azonenberg/ethernet-tap/board/ethernet-tap.kicad_pcb

## KiCad design board/ethernet-tap.kicad_pcb (2022-12-27)

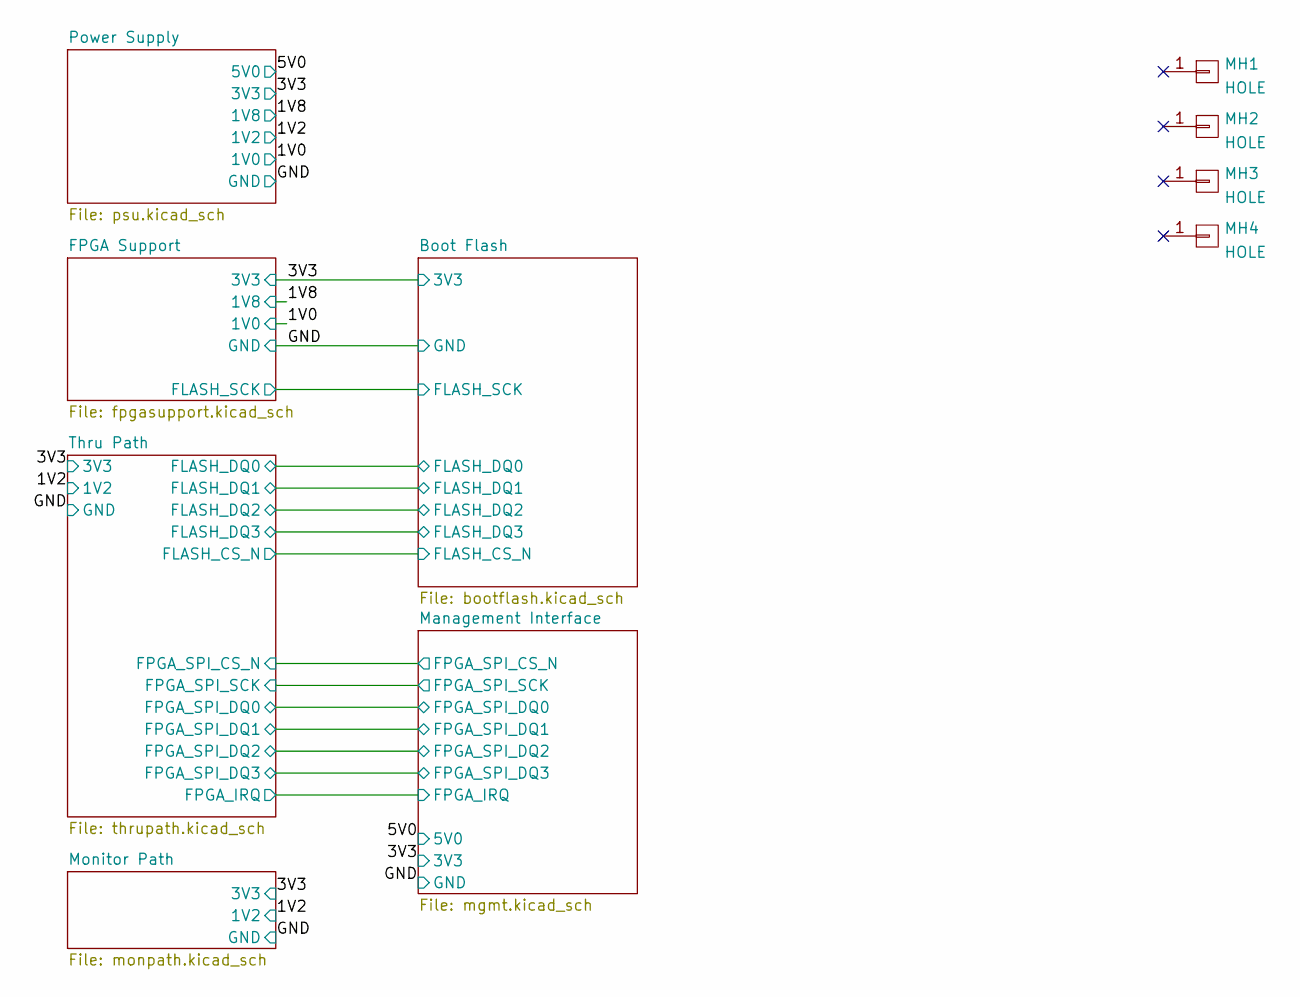
[picture p1: schematic ethernet-tap.kicad_sch, Active 10/100/1000baseT Tap]

Parts:
MH1, MH2, MH3, MH4: HOLE; MECHANICAL_CLEARANCEHOLE_4_40

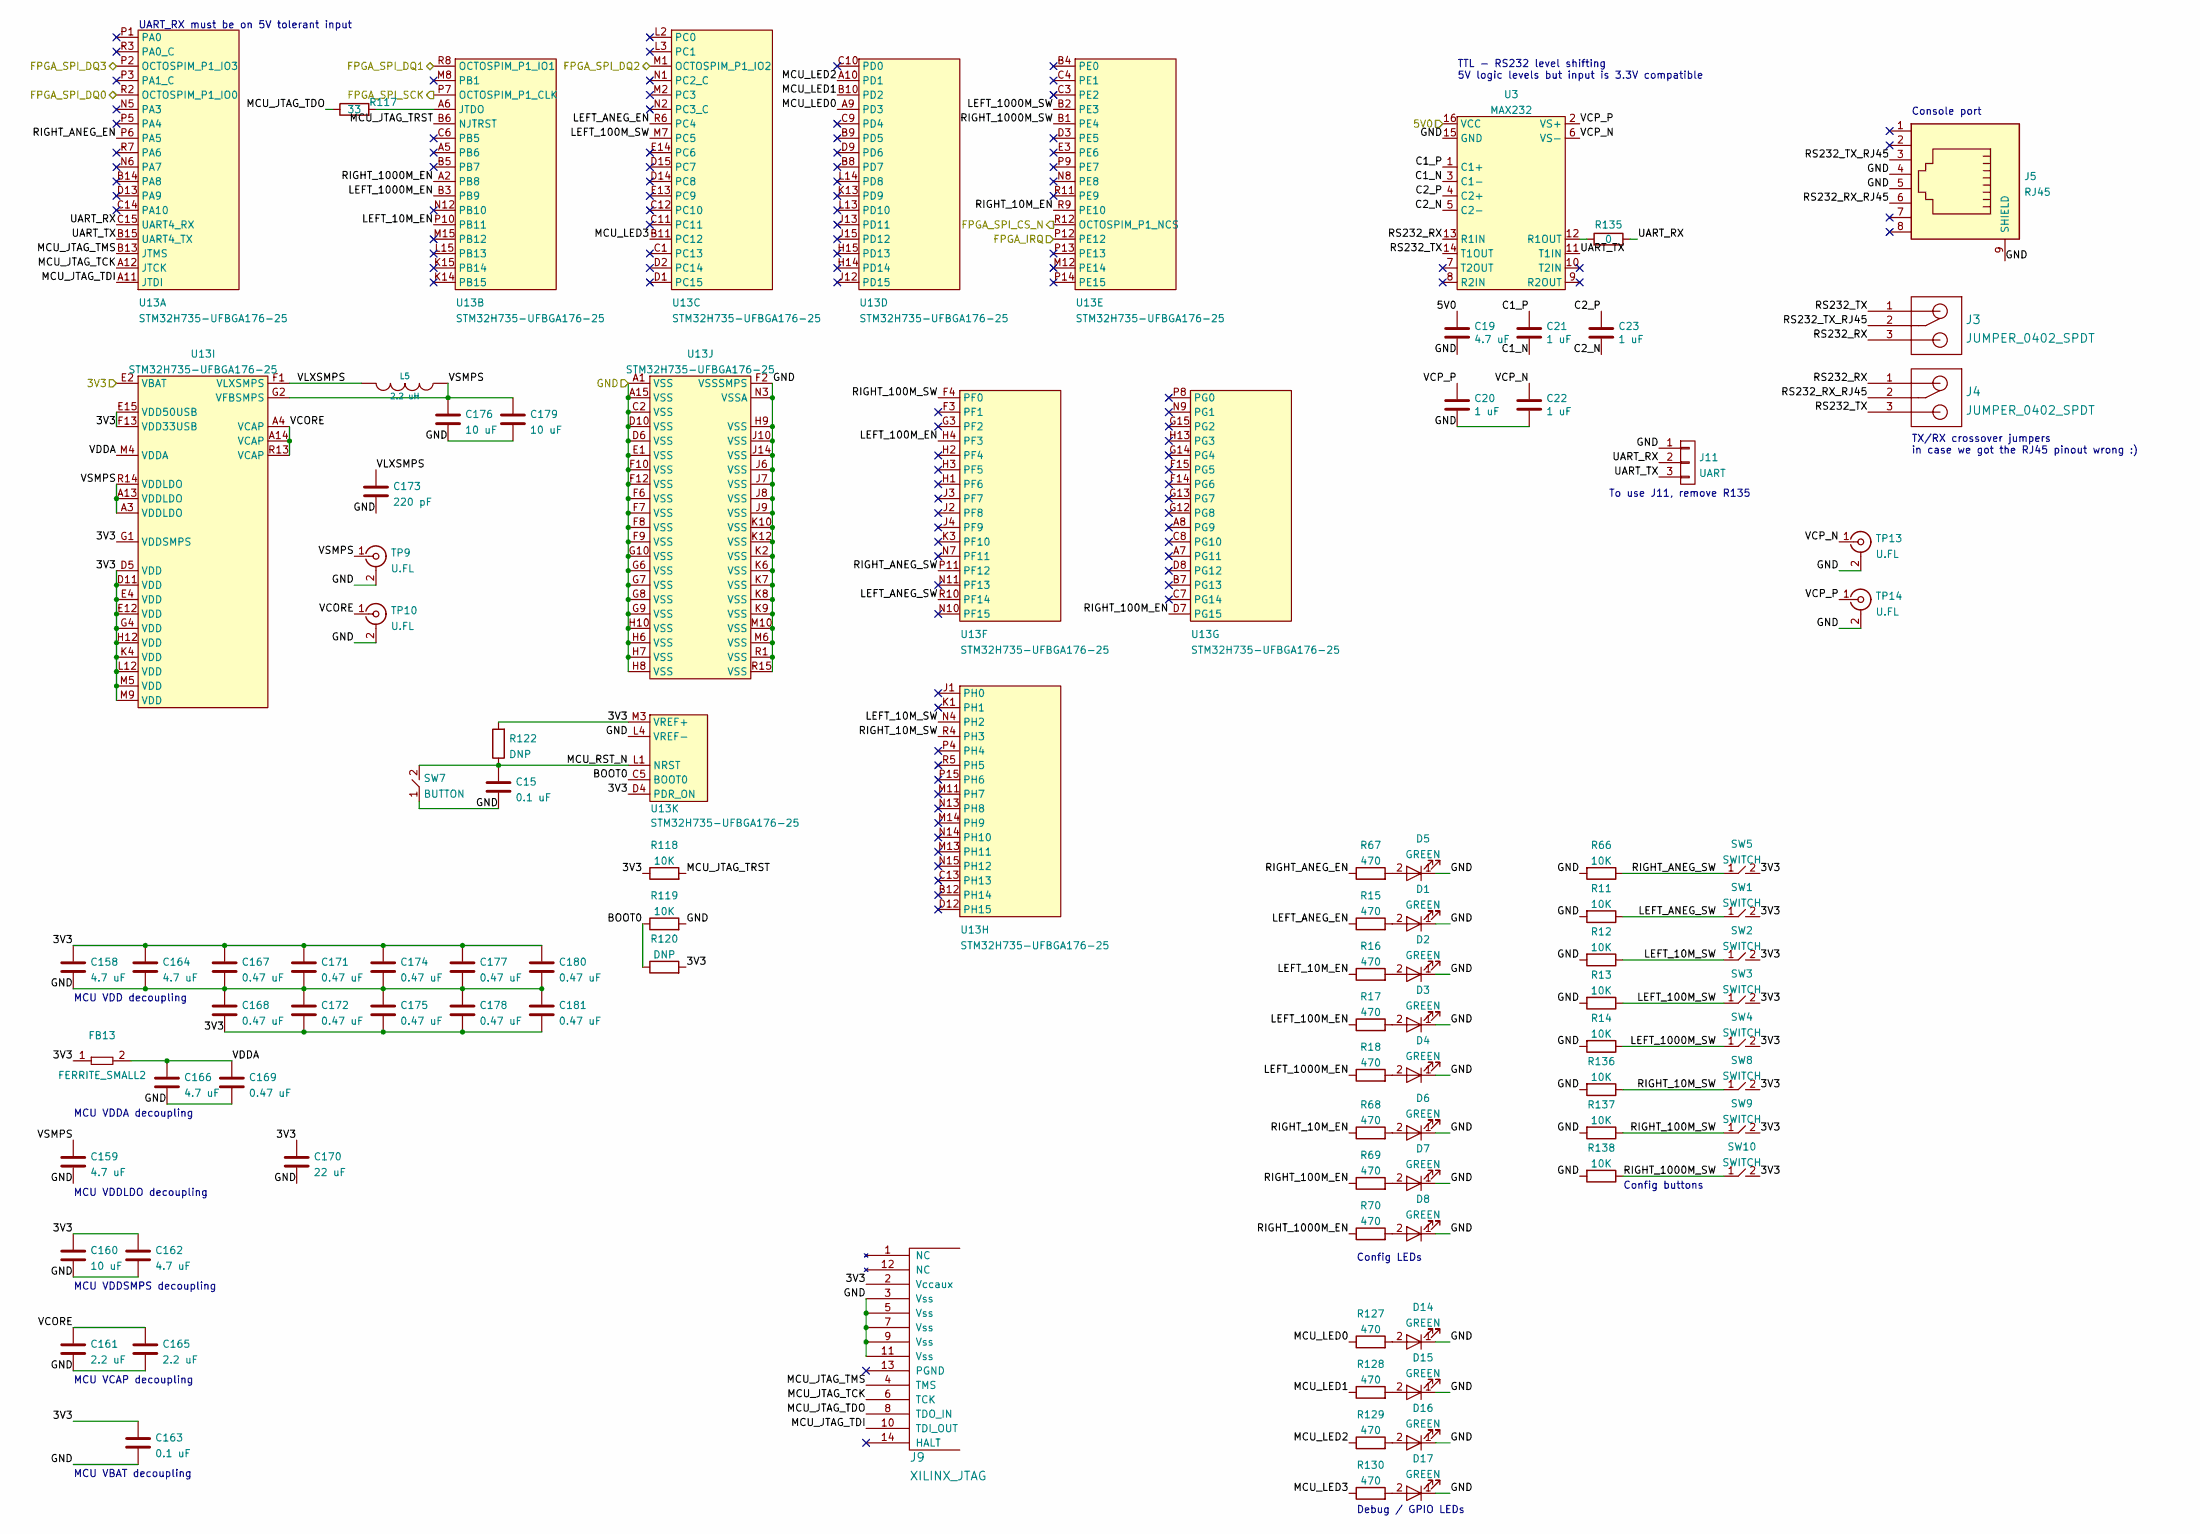
[picture p2: schematic mgmt.kicad_sch, Active 10/100/1000baseT Tap]

Parts:
C15, C163: 0.1 uF; EIA_0402_CAP_NOSILK
C19, C158, C159, C162, C164, C166: 4.7 uF; EIA_0603_CAP_NOSILK
C20, C21, C22, C23: 1 uF; EIA_0603_CAP_NOSILK
C160, C176, C179: 10 uF; EIA_0805_CAP_NOSILK
C161, C165: 2.2 uF; EIA_0603_CAP_NOSILK
C167, C168, C169, C171, C172, C174, C175, C177, C178, C180, C181: 0.47 uF; EIA_0402_CAP_NOSILK
C170: 22 uF; EIA_1206_CAP_NOSILK
C173: 220 pF; EIA_0402_CAP_NOSILK
D1, D2, D3, D4, D5, D6, D7, D8, D14, D15, D16, D17: GREEN; EIA_0603_LED
FB13: FERRITE_SMALL2; EIA_0603_INDUCTOR_NOSILK
J3, J4: JUMPER_0402_SPDT; EIA_0402_JUMPER
J5: RJ45; CONN_RJ45_BELSTEWART_SS-7188S-A-PG4-1-BA-xx
J9: XILINX_JTAG; XILINX_JTAG_PTH_MOLEX_0878311420
J11: UART; CONN_HEADER_2.54MM_1x3
L5: 2.2 uH; EIA_1210_CAP_NOSILK
R11, R12, R13, R14, R66, R118, R119, R136, R137, R138: 10K; EIA_0402_RES_NOSILK
R15, R16, R17, R18, R67, R68, R69, R70, R127, R128, R129, R130: 470; EIA_0402_RES_NOSILK
R117: 33; EIA_0402_RES_NOSILK
R120, R122: DNP; EIA_0402_RES_NOSILK
R135: 0; EIA_0402_RES_NOSILK
SW1, SW2, SW3, SW4, SW5, SW8, SW9, SW10: SWITCH; SWITCH_RAFI_MICON_5
SW7: BUTTON; SWITCH_RAFI_MICON_5
TP9, TP10, TP13, TP14: U.FL; CONN_U.FL_TE_1909763-1
U3: MAX232; SOIC_16_3.9MM
U13: STM32H735-UFBGA176-25; BGA_201_10x10_DEPOP_0.65MM_OSHPARK

Connections:
/3V3: C158.1, C160.1, C162.1, C163.1, C164.1, C167.1, C168.2, C170.1, C171.1, C172.2, C174.1, C175.2, C177.1, C178.2, C180.1, C181.2, FB13.1, J9.2 (Vccaux), R118.1, R120.2, R122.2, SW1.2, SW2.2, SW3.2, SW4.2, SW5.2, SW8.2, SW9.2, SW10.2, U13.D4 (PDR_ON), U13.D5 (VDD), U13.D11 (VDD), U13.E2 (VBAT), U13.E4 (VDD), U13.E12 (VDD), U13.E15 (VDD50USB), U13.F13 (VDD33USB), U13.G1 (VDDSMPS), U13.G4 (VDD), U13.H12 (VDD), U13.K4 (VDD), U13.L12 (VDD), U13.M3 (VREF+), U13.M5 (VDD), U13.M9 (VDD); also elsewhere on the board
/5V0: C19.1, U3.16 (VCC); also elsewhere on the board
/GND: C15.2, C19.2, C20.2, C22.2, C158.2, C159.2, C160.2, C161.2, C162.2, C163.2, C164.2, C165.2, C166.2, C167.2, C168.1, C169.2, C170.2, C171.2, C172.1, C173.2, C174.2, C175.1, C176.2, C177.2, C178.1, C179.2, C180.2, C181.1, D1.1 (K), D2.1 (K), D3.1 (K), D4.1 (K), D5.1 (K), D6.1 (K), D7.1 (K), D8.1 (K), D14.1 (K), D15.1 (K), D16.1 (K), D17.1 (K), J5.4, J5.5, J5.9 (SHIELD), J9.3 (Vss), J9.5 (Vss), J9.7 (Vss), J9.9 (Vss), J9.11 (Vss), J11.1, R11.2, R12.2, R13.2, R14.2, R66.2, R119.2, R136.2, R137.2, R138.2, SW7.1, TP9.2 (Ext), TP10.2 (Ext), TP13.2 (Ext), TP14.2 (Ext), U3.15 (GND), U13.A1 (VSS), U13.A15 (VSS), U13.C2 (VSS), U13.D6 (VSS), U13.D10 (VSS), U13.E1 (VSS), U13.F2 (VSSSMPS), U13.F6 (VSS), U13.F7 (VSS), U13.F8 (VSS), U13.F9 (VSS), U13.F10 (VSS), U13.F12 (VSS), U13.G6 (VSS), U13.G7 (VSS), U13.G8 (VSS), U13.G9 (VSS), U13.G10 (VSS), U13.H6 (VSS), U13.H7 (VSS), U13.H8 (VSS), U13.H9 (VSS), U13.H10 (VSS), U13.J6 (VSS), U13.J7 (VSS), U13.J8 (VSS), U13.J9 (VSS), U13.J10 (VSS), U13.J14 (VSS), U13.K2 (VSS), U13.K6 (VSS), U13.K7 (VSS), U13.K8 (VSS), U13.K9 (VSS), U13.K10 (VSS), U13.K12 (VSS), U13.L4 (VREF-), U13.M6 (VSS), U13.M10 (VSS), U13.N3 (VSSA), U13.R1 (VSS), U13.R15 (VSS); also elsewhere on the board
/Management Interface/BOOT0: R119.1, R120.1, U13.C5 (BOOT0)
/Management Interface/C1_N: C21.2, U3.3 (C1-)
/Management Interface/C1_P: C21.1, U3.1 (C1+)
/Management Interface/C2_N: C23.2, U3.5 (C2-)
/Management Interface/C2_P: C23.1, U3.4 (C2+)
/Management Interface/FPGA_IRQ: U13.P12 (PE12); also elsewhere on the board
/Management Interface/FPGA_SPI_CS_N: U13.R12 (OCTOSPIM_P1_NCS); also elsewhere on the board
/Management Interface/FPGA_SPI_DQ0: U13.R2 (OCTOSPIM_P1_IO0); also elsewhere on the board
/Management Interface/FPGA_SPI_DQ1: U13.R8 (OCTOSPIM_P1_IO1); also elsewhere on the board
/Management Interface/FPGA_SPI_DQ2: U13.M1 (OCTOSPIM_P1_IO2); also elsewhere on the board
/Management Interface/FPGA_SPI_DQ3: U13.P2 (OCTOSPIM_P1_IO3); also elsewhere on the board
/Management Interface/FPGA_SPI_SCK: U13.P7 (OCTOSPIM_P1_CLK); also elsewhere on the board
/Management Interface/LEFT_10M_EN: R16.1, U13.P10 (PB11)
/Management Interface/LEFT_10M_SW: R12.1, SW2.1, U13.N4 (PH2)
/Management Interface/LEFT_100M_EN: R17.1, U13.H4 (PF3)
/Management Interface/LEFT_100M_SW: R13.1, SW3.1, U13.M7 (PC5)
/Management Interface/LEFT_1000M_EN: R18.1, U13.B3 (PB9)
/Management Interface/LEFT_1000M_SW: R14.1, SW4.1, U13.B2 (PE3)
/Management Interface/LEFT_ANEG_EN: R15.1, U13.R6 (PC4)
/Management Interface/LEFT_ANEG_SW: R11.1, SW1.1, U13.R10 (PF14)
/Management Interface/MCU_JTAG_TCK: J9.6 (TCK), U13.A12 (JTCK)
/Management Interface/MCU_JTAG_TDI: J9.10 (TDI_OUT), U13.A11 (JTDI)
/Management Interface/MCU_JTAG_TDO: J9.8 (TDO_IN), R117.1
/Management Interface/MCU_JTAG_TMS: J9.4 (TMS), U13.B13 (JTMS)
/Management Interface/MCU_JTAG_TRST: R118.2, U13.B6 (NJTRST)
/Management Interface/MCU_LED0: R127.1, U13.A9 (PD3)
/Management Interface/MCU_LED1: R128.1, U13.B10 (PD2)
/Management Interface/MCU_LED2: R129.1, U13.A10 (PD1)
/Management Interface/MCU_LED3: R130.1, U13.B11 (PC12)
/Management Interface/MCU_RST_N: C15.1, R122.1, SW7.2, U13.L1 (NRST)
/Management Interface/RIGHT_10M_EN: R68.1, U13.R9 (PE10)
/Management Interface/RIGHT_10M_SW: R136.1, SW8.1, U13.R4 (PH3)
/Management Interface/RIGHT_100M_EN: R69.1, U13.D7 (PG15)
/Management Interface/RIGHT_100M_SW: R137.1, SW9.1, U13.F4 (PF0)
/Management Interface/RIGHT_1000M_EN: R70.1, U13.A2 (PB8)
/Management Interface/RIGHT_1000M_SW: R138.1, SW10.1, U13.B1 (PE4)
/Management Interface/RIGHT_ANEG_EN: R67.1, U13.P6 (PA5)
/Management Interface/RIGHT_ANEG_SW: R66.1, SW5.1, U13.P11 (PF12)
/Management Interface/RS232_RX: J3.3, J4.1, U3.13 (R1IN)
/Management Interface/RS232_RX_RJ45: J4.2, J5.6
/Management Interface/RS232_TX: J3.1, J4.3, U3.14 (T1OUT)
/Management Interface/RS232_TX_RJ45: J3.2, J5.3
/Management Interface/UART_RX: J11.2, R135.2, U13.C15 (UART4_RX)
/Management Interface/UART_TX: J11.3, U3.11 (T1IN), U13.B15 (UART4_TX)
/Management Interface/VCORE: C161.1, C165.1, TP10.1 (In), U13.A4 (VCAP), U13.A14 (VCAP), U13.R13 (VCAP)
/Management Interface/VCP_N: C22.1, TP13.1 (In), U3.6 (VS-)
/Management Interface/VCP_P: C20.1, TP14.1 (In), U3.2 (VS+)
/Management Interface/VDDA: C166.1, C169.1, FB13.2, U13.M4 (VDDA)
/Management Interface/VLXSMPS: C173.1, L5.2, U13.F1 (VLXSMPS)
/Management Interface/VSMPS: C159.1, C176.1, C179.1, L5.1, TP9.1 (In), U13.A3 (VDDLDO), U13.A13 (VDDLDO), U13.G2 (VFBSMPS), U13.R14 (VDDLDO)
unnamed: D1.2 (A), R15.2
unnamed: D2.2 (A), R16.2
unnamed: D3.2 (A), R17.2
unnamed: D4.2 (A), R18.2
unnamed: D5.2 (A), R67.2
unnamed: D6.2 (A), R68.2
unnamed: D7.2 (A), R69.2
unnamed: D8.2 (A), R70.2
unnamed: D14.2 (A), R127.2
unnamed: D15.2 (A), R128.2
unnamed: D16.2 (A), R129.2
unnamed: D17.2 (A), R130.2
unnamed: R117.2, U13.A6 (JTDO)
unnamed: R135.1, U3.12 (R1OUT)

Notes on the sheet:
TX/RX crossover jumpers in case we got the RJ45 pinout wrong :)
MCU VCAP decoupling
Config buttons
Console port
UART_RX must be on 5V tolerant input
To use J11, remove R135
MCU VDDSMPS decoupling
MCU VDDA decoupling
MCU VBAT decoupling
MCU VDD decoupling
Debug / GPIO LEDs
Config LEDs
MCU VDDLDO decoupling
TTL - RS232 level shifting 5V logic levels but input is 3.3V compatible

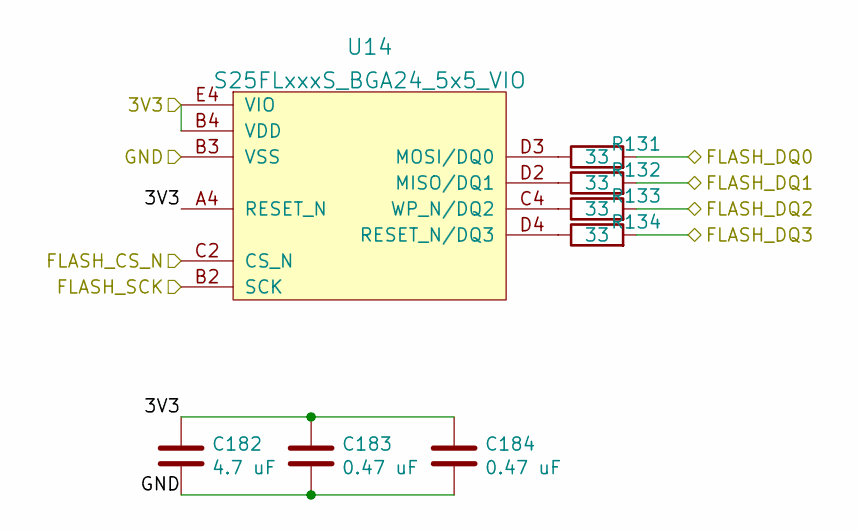
[picture p3: schematic bootflash.kicad_sch, Active 10/100/1000baseT Tap]

Parts:
C182: 4.7 uF; EIA_0603_CAP_NOSILK
C183, C184: 0.47 uF; EIA_0402_CAP_NOSILK
R131, R132, R133, R134: 33; EIA_0402_RES_NOSILK
U14: S25FLxxxS_BGA24_5x5_VIO; BGA_24_6x8_DEPOP1_1MM

Connections:
/3V3: C182.1, C183.1, C184.1, U14.A4 (RESET_N), U14.B4 (VDD), U14.E4 (VIO); also elsewhere on the board
/Boot Flash/FLASH_CS_N: U14.C2 (CS_N); also elsewhere on the board
/Boot Flash/FLASH_DQ0: R131.2; also elsewhere on the board
/Boot Flash/FLASH_DQ1: R132.2; also elsewhere on the board
/Boot Flash/FLASH_DQ2: R133.2; also elsewhere on the board
/Boot Flash/FLASH_DQ3: R134.2; also elsewhere on the board
/Boot Flash/FLASH_SCK: U14.B2 (SCK); also elsewhere on the board
/GND: C182.2, C183.2, C184.2, U14.B3 (VSS); also elsewhere on the board
unnamed: R131.1, U14.D3 (MOSI/DQ0)
unnamed: R132.1, U14.D2 (MISO/DQ1)
unnamed: R133.1, U14.C4 (WP_N/DQ2)
unnamed: R134.1, U14.D4 (RESET_N/DQ3)

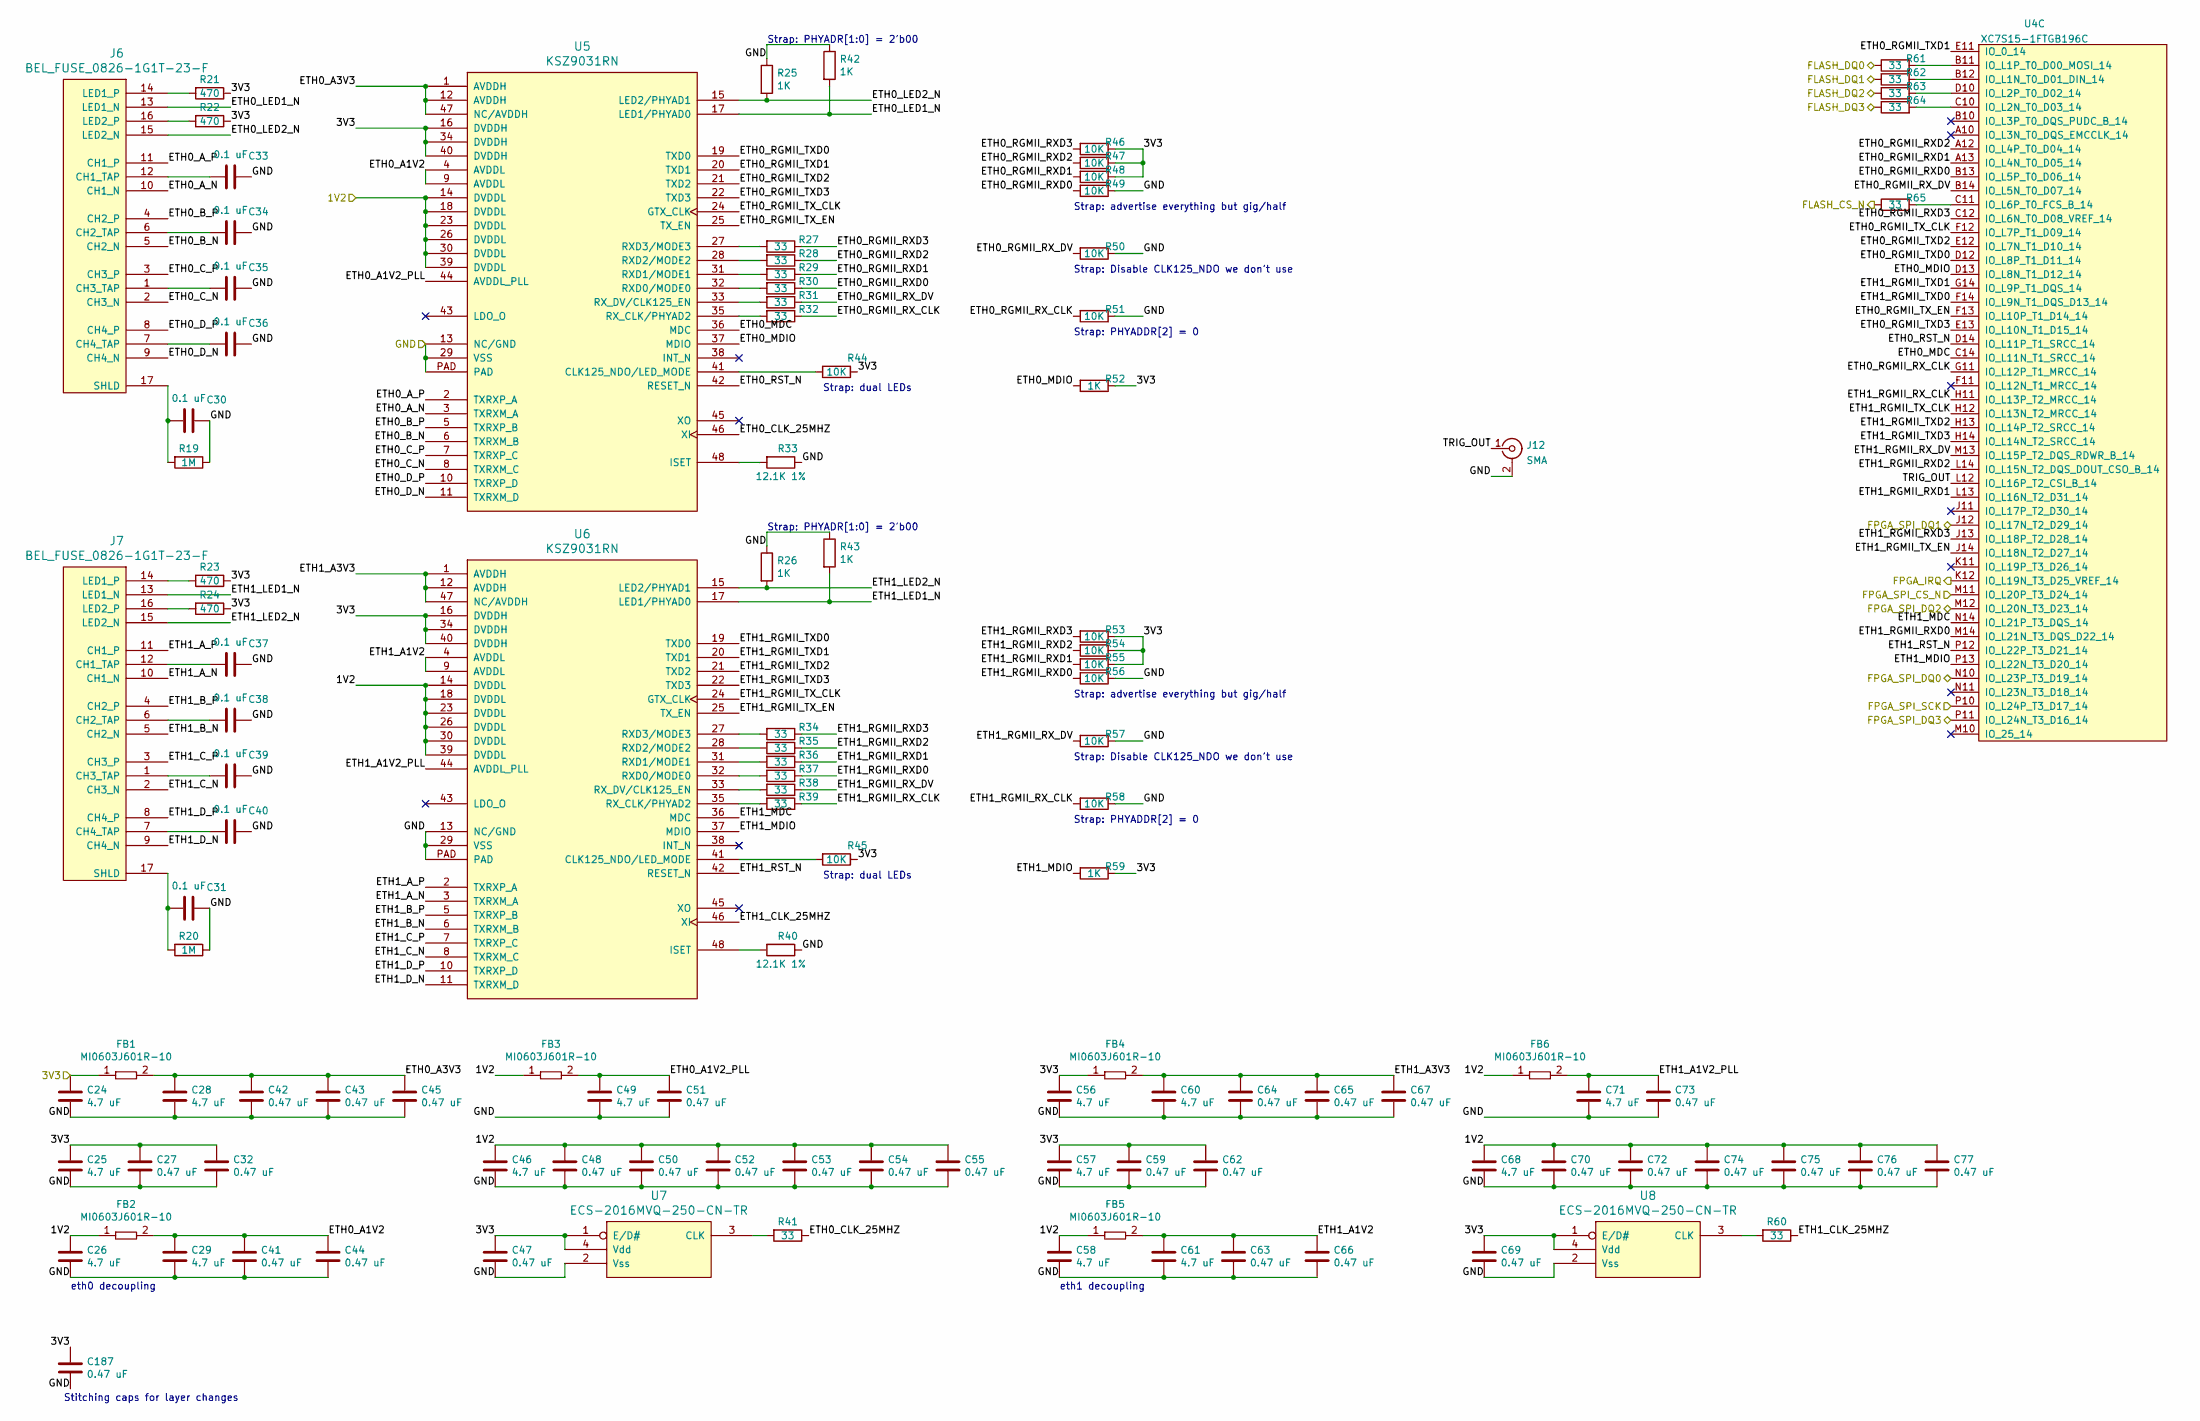
[picture p4: schematic thrupath.kicad_sch, Active 10/100/1000baseT Tap]

Parts:
C24, C25, C26, C28, C29, C46, C49, C56, C57, C58, C60, C61, C68, C71: 4.7 uF; EIA_0603_CAP_NOSILK
C27, C32, C41, C42, C43, C44, C45, C47, C48, C50, C51, C52, C53, C54, C55, C59, C62, C63, C64, C65, C66, C67, C69, C70, C72, C73, C74, C75, C76, C77, C187: 0.47 uF; EIA_0402_CAP_NOSILK
C30, C31, C33, C34, C35, C36, C37, C38, C39, C40: 0.1 uF; EIA_0402_CAP_NOSILK
FB1, FB2, FB3, FB4, FB5, FB6: MI0603J601R-10; EIA_0603_INDUCTOR_NOSILK
J6, J7: BEL_FUSE_0826-1G1T-23-F; CONN_BELFUSE_0826_1G1T_23_F
J12: SMA; CONN_SMA_EDGE_SAMTEC_SMA_J_P_H_ST_EM1
R19, R20: 1M; EIA_0402_RES_NOSILK
R21, R22, R23, R24: 470; EIA_0402_RES_NOSILK
R25, R26, R42, R43, R52, R59: 1K; EIA_0402_RES_NOSILK
R27, R28, R29, R30, R31, R32, R34, R35, R36, R37, R38, R39, R41, R60, R61, R62, R63, R64, R65: 33; EIA_0402_RES_NOSILK
R33, R40: 12.1K 1%; EIA_0402_RES_NOSILK
R44, R45, R46, R47, R48, R49, R50, R51, R53, R54, R55, R56, R57, R58: 10K; EIA_0402_RES_NOSILK
U4: XC7S15-1FTGB196C; BGA_196_15x15_FULLARRAY_1MM_FTGB196
U5, U6: KSZ9031RN; QFN_48_0.5MM_7x7MM
U7, U8: ECS-2016MVQ-250-CN-TR; OSCILLATOR_2.0x1.6

Connections:
/1V2: C26.1, C46.1, C48.1, C50.1, C52.1, C53.1, C54.1, C55.1, C58.1, C68.1, C70.1, C72.1, C74.1, C75.1, C76.1, C77.1, FB2.1, FB3.1, FB5.1, FB6.1, U5.14 (DVDDL), U5.18 (DVDDL), U5.23 (DVDDL), U5.26 (DVDDL), U5.30 (DVDDL), U5.39 (DVDDL), U6.14 (DVDDL), U6.18 (DVDDL), U6.23 (DVDDL), U6.26 (DVDDL), U6.30 (DVDDL), U6.39 (DVDDL); also elsewhere on the board
/3V3: C24.1, C25.1, C27.1, C32.1, C47.1, C56.1, C57.1, C59.1, C62.1, C69.1, C187.1, FB1.1, FB4.1, R21.1, R22.1, R23.1, R24.1, R44.1, R45.1, R46.1, R47.1, R48.1, R52.1, R53.1, R54.1, R55.1, R59.1, U5.16 (DVDDH), U5.34 (DVDDH), U5.40 (DVDDH), U6.16 (DVDDH), U6.34 (DVDDH), U6.40 (DVDDH), U7.1 (E/D#), U7.4 (Vdd), U8.1 (E/D#), U8.4 (Vdd); also elsewhere on the board
/Boot Flash/FLASH_CS_N: R65.1; also elsewhere on the board
/Boot Flash/FLASH_DQ0: R61.1; also elsewhere on the board
/Boot Flash/FLASH_DQ1: R62.1; also elsewhere on the board
/Boot Flash/FLASH_DQ2: R63.1; also elsewhere on the board
/Boot Flash/FLASH_DQ3: R64.1; also elsewhere on the board
/GND: C24.2, C25.2, C26.2, C27.2, C28.2, C29.2, C30.1, C31.1, C32.2, C33.1, C34.1, C35.1, C36.1, C37.1, C38.1, C39.1, C40.1, C41.2, C42.2, C43.2, C44.2, C45.2, C46.2, C47.2, C48.2, C49.2, C50.2, C51.2, C52.2, C53.2, C54.2, C55.2, C56.2, C57.2, C58.2, C59.2, C60.2, C61.2, C62.2, C63.2, C64.2, C65.2, C66.2, C67.2, C68.2, C69.2, C70.2, C71.2, C72.2, C73.2, C74.2, C75.2, C76.2, C77.2, C187.2, J12.2 (Ext), R19.1, R20.1, R25.1, R26.1, R33.1, R40.1, R42.1, R43.1, R49.1, R50.1, R51.1, R56.1, R57.1, R58.1, U5.13 (NC/GND), U5.29 (VSS), U5.PAD, U6.13 (NC/GND), U6.29 (VSS), U6.PAD, U7.2 (Vss), U8.2 (Vss); also elsewhere on the board
/Management Interface/FPGA_IRQ: U4.K12 (IO_L19N_T3_D25_VREF_14); also elsewhere on the board
/Management Interface/FPGA_SPI_CS_N: U4.M11 (IO_L20P_T3_D24_14); also elsewhere on the board
/Management Interface/FPGA_SPI_DQ0: U4.N10 (IO_L23P_T3_D19_14); also elsewhere on the board
/Management Interface/FPGA_SPI_DQ1: U4.J12 (IO_L17N_T2_D29_14); also elsewhere on the board
/Management Interface/FPGA_SPI_DQ2: U4.M12 (IO_L20N_T3_D23_14); also elsewhere on the board
/Management Interface/FPGA_SPI_DQ3: U4.P11 (IO_L24N_T3_D16_14); also elsewhere on the board
/Management Interface/FPGA_SPI_SCK: U4.P10 (IO_L24P_T3_D17_14); also elsewhere on the board
/Thru Path/ETH0_A1V2: C29.1, C41.1, C44.1, FB2.2, U5.4 (AVDDL), U5.9 (AVDDL)
/Thru Path/ETH0_A1V2_PLL: C49.1, C51.1, FB3.2, U5.44 (AVDDL_PLL)
/Thru Path/ETH0_A3V3: C28.1, C42.1, C43.1, C45.1, FB1.2, U5.1 (AVDDH), U5.12 (AVDDH), U5.47 (NC/AVDDH)
/Thru Path/ETH0_A_N: J6.10 (CH1_N), U5.3 (TXRXM_A)
/Thru Path/ETH0_A_P: J6.11 (CH1_P), U5.2 (TXRXP_A)
/Thru Path/ETH0_B_N: J6.5 (CH2_N), U5.6 (TXRXM_B)
/Thru Path/ETH0_B_P: J6.4 (CH2_P), U5.5 (TXRXP_B)
/Thru Path/ETH0_CLK_25MHZ: R41.1, U5.46 (XI)
/Thru Path/ETH0_C_N: J6.2 (CH3_N), U5.8 (TXRXM_C)
/Thru Path/ETH0_C_P: J6.3 (CH3_P), U5.7 (TXRXP_C)
/Thru Path/ETH0_D_N: J6.9 (CH4_N), U5.11 (TXRXM_D)
/Thru Path/ETH0_D_P: J6.8 (CH4_P), U5.10 (TXRXP_D)
/Thru Path/ETH0_LED1_N: J6.13 (LED1_N), R42.2, U5.17 (LED1/PHYAD0)
/Thru Path/ETH0_LED2_N: J6.15 (LED2_N), R25.2, U5.15 (LED2/PHYAD1)
/Thru Path/ETH0_MDC: U4.C14 (IO_L11N_T1_SRCC_14), U5.36 (MDC)
/Thru Path/ETH0_MDIO: R52.2, U4.D13 (IO_L8N_T1_D12_14), U5.37 (MDIO)
/Thru Path/ETH0_RGMII_RXD0: R30.1, R49.2, U4.B13 (IO_L5P_T0_D06_14)
/Thru Path/ETH0_RGMII_RXD1: R29.1, R48.2, U4.A13 (IO_L4N_T0_D05_14)
/Thru Path/ETH0_RGMII_RXD2: R28.1, R47.2, U4.A12 (IO_L4P_T0_D04_14)
/Thru Path/ETH0_RGMII_RXD3: R27.1, R46.2, U4.C12 (IO_L6N_T0_D08_VREF_14)
/Thru Path/ETH0_RGMII_RX_CLK: R32.1, R51.2, U4.G11 (IO_L12P_T1_MRCC_14)
/Thru Path/ETH0_RGMII_RX_DV: R31.1, R50.2, U4.B14 (IO_L5N_T0_D07_14)
/Thru Path/ETH0_RGMII_TXD0: U4.D12 (IO_L8P_T1_D11_14), U5.19 (TXD0)
/Thru Path/ETH0_RGMII_TXD1: U4.E11 (IO_0_14), U5.20 (TXD1)
/Thru Path/ETH0_RGMII_TXD2: U4.E12 (IO_L7N_T1_D10_14), U5.21 (TXD2)
/Thru Path/ETH0_RGMII_TXD3: U4.E13 (IO_L10N_T1_D15_14), U5.22 (TXD3)
/Thru Path/ETH0_RGMII_TX_CLK: U4.F12 (IO_L7P_T1_D09_14), U5.24 (GTX_CLK)
/Thru Path/ETH0_RGMII_TX_EN: U4.F13 (IO_L10P_T1_D14_14), U5.25 (TX_EN)
/Thru Path/ETH0_RST_N: U4.D14 (IO_L11P_T1_SRCC_14), U5.42 (RESET_N)
/Thru Path/ETH1_A1V2: C61.1, C63.1, C66.1, FB5.2, U6.4 (AVDDL), U6.9 (AVDDL)
/Thru Path/ETH1_A1V2_PLL: C71.1, C73.1, FB6.2, U6.44 (AVDDL_PLL)
/Thru Path/ETH1_A3V3: C60.1, C64.1, C65.1, C67.1, FB4.2, U6.1 (AVDDH), U6.12 (AVDDH), U6.47 (NC/AVDDH)
/Thru Path/ETH1_A_N: J7.10 (CH1_N), U6.3 (TXRXM_A)
/Thru Path/ETH1_A_P: J7.11 (CH1_P), U6.2 (TXRXP_A)
/Thru Path/ETH1_B_N: J7.5 (CH2_N), U6.6 (TXRXM_B)
/Thru Path/ETH1_B_P: J7.4 (CH2_P), U6.5 (TXRXP_B)
/Thru Path/ETH1_CLK_25MHZ: R60.1, U6.46 (XI)
/Thru Path/ETH1_C_N: J7.2 (CH3_N), U6.8 (TXRXM_C)
/Thru Path/ETH1_C_P: J7.3 (CH3_P), U6.7 (TXRXP_C)
/Thru Path/ETH1_D_N: J7.9 (CH4_N), U6.11 (TXRXM_D)
/Thru Path/ETH1_D_P: J7.8 (CH4_P), U6.10 (TXRXP_D)
/Thru Path/ETH1_LED1_N: J7.13 (LED1_N), R43.2, U6.17 (LED1/PHYAD0)
/Thru Path/ETH1_LED2_N: J7.15 (LED2_N), R26.2, U6.15 (LED2/PHYAD1)
/Thru Path/ETH1_MDC: U4.N14 (IO_L21P_T3_DQS_14), U6.36 (MDC)
/Thru Path/ETH1_MDIO: R59.2, U4.P13 (IO_L22N_T3_D20_14), U6.37 (MDIO)
/Thru Path/ETH1_RGMII_RXD0: R37.1, R56.2, U4.M14 (IO_L21N_T3_DQS_D22_14)
/Thru Path/ETH1_RGMII_RXD1: R36.1, R55.2, U4.L13 (IO_L16N_T2_D31_14)
/Thru Path/ETH1_RGMII_RXD2: R35.1, R54.2, U4.L14 (IO_L15N_T2_DQS_DOUT_CSO_B_14)
/Thru Path/ETH1_RGMII_RXD3: R34.1, R53.2, U4.J13 (IO_L18P_T2_D28_14)
/Thru Path/ETH1_RGMII_RX_CLK: R39.1, R58.2, U4.H11 (IO_L13P_T2_MRCC_14)
/Thru Path/ETH1_RGMII_RX_DV: R38.1, R57.2, U4.M13 (IO_L15P_T2_DQS_RDWR_B_14)
/Thru Path/ETH1_RGMII_TXD0: U4.F14 (IO_L9N_T1_DQS_D13_14), U6.19 (TXD0)
/Thru Path/ETH1_RGMII_TXD1: U4.G14 (IO_L9P_T1_DQS_14), U6.20 (TXD1)
/Thru Path/ETH1_RGMII_TXD2: U4.H13 (IO_L14P_T2_SRCC_14), U6.21 (TXD2)
/Thru Path/ETH1_RGMII_TXD3: U4.H14 (IO_L14N_T2_SRCC_14), U6.22 (TXD3)
/Thru Path/ETH1_RGMII_TX_CLK: U4.H12 (IO_L13N_T2_MRCC_14), U6.24 (GTX_CLK)
/Thru Path/ETH1_RGMII_TX_EN: U4.J14 (IO_L18N_T2_D27_14), U6.25 (TX_EN)
/Thru Path/ETH1_RST_N: U4.P12 (IO_L22P_T3_D21_14), U6.42 (RESET_N)
/Thru Path/TRIG_OUT: J12.1 (In), U4.L12 (IO_L16P_T2_CSI_B_14)
unnamed: C30.2, J6.17 (SHLD), R19.2
unnamed: C31.2, J7.17 (SHLD), R20.2
unnamed: C33.2, J6.12 (CH1_TAP)
unnamed: C34.2, J6.6 (CH2_TAP)
unnamed: C35.2, J6.1 (CH3_TAP)
unnamed: C36.2, J6.7 (CH4_TAP)
unnamed: C37.2, J7.12 (CH1_TAP)
unnamed: C38.2, J7.6 (CH2_TAP)
unnamed: C39.2, J7.1 (CH3_TAP)
unnamed: C40.2, J7.7 (CH4_TAP)
unnamed: J6.14 (LED1_P), R21.2
unnamed: J6.16 (LED2_P), R22.2
unnamed: J7.14 (LED1_P), R23.2
unnamed: J7.16 (LED2_P), R24.2
unnamed: R27.2, U5.27 (RXD3/MODE3)
unnamed: R28.2, U5.28 (RXD2/MODE2)
unnamed: R29.2, U5.31 (RXD1/MODE1)
unnamed: R30.2, U5.32 (RXD0/MODE0)
unnamed: R31.2, U5.33 (RX_DV/CLK125_EN)
unnamed: R32.2, U5.35 (RX_CLK/PHYAD2)
unnamed: R33.2, U5.48 (ISET)
unnamed: R34.2, U6.27 (RXD3/MODE3)
unnamed: R35.2, U6.28 (RXD2/MODE2)
unnamed: R36.2, U6.31 (RXD1/MODE1)
unnamed: R37.2, U6.32 (RXD0/MODE0)
unnamed: R38.2, U6.33 (RX_DV/CLK125_EN)
unnamed: R39.2, U6.35 (RX_CLK/PHYAD2)
unnamed: R40.2, U6.48 (ISET)
unnamed: R41.2, U7.3 (CLK)
unnamed: R44.2, U5.41 (CLK125_NDO/LED_MODE)
unnamed: R45.2, U6.41 (CLK125_NDO/LED_MODE)
unnamed: R60.2, U8.3 (CLK)
unnamed: R61.2, U4.B11 (IO_L1P_T0_D00_MOSI_14)
unnamed: R62.2, U4.B12 (IO_L1N_T0_D01_DIN_14)
unnamed: R63.2, U4.D10 (IO_L2P_T0_D02_14)
unnamed: R64.2, U4.C10 (IO_L2N_T0_D03_14)
unnamed: R65.2, U4.C11 (IO_L6P_T0_FCS_B_14)

Notes on the sheet:
Strap: advertise everything but gig/half
Strap: dual LEDs
Stitching caps for layer changes
Strap: PHYADDR[2] = 0
eth1 decoupling
Strap: PHYADR[1:0] = 2'b00
Strap: Disable CLK125_NDO we don't use
eth0 decoupling

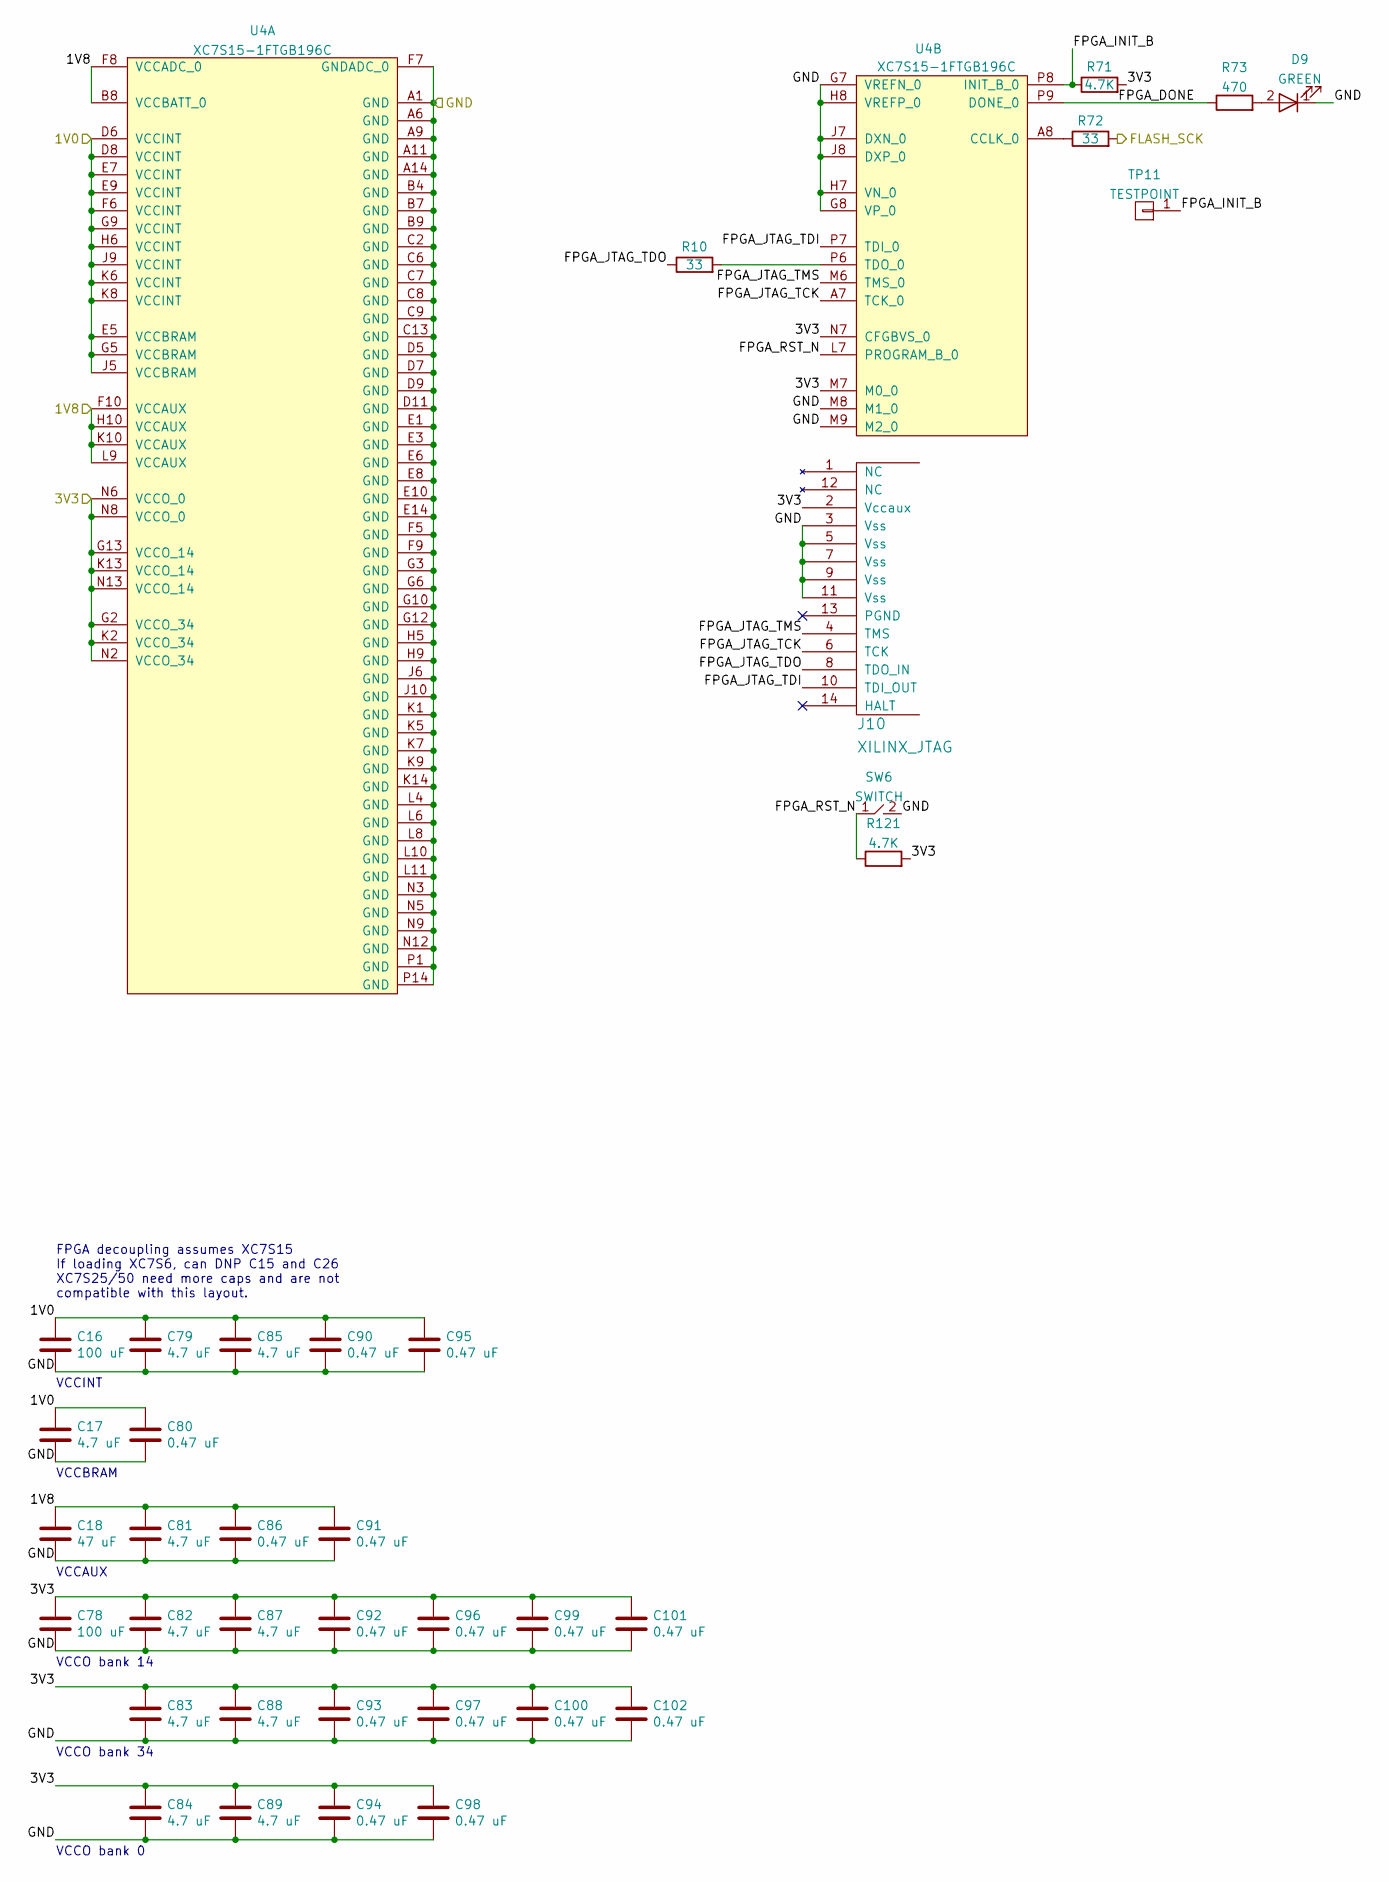
[picture p5: schematic fpgasupport.kicad_sch, Active 10/100/1000baseT Tap]

Parts:
C16: 100 uF; EIA_1210_CAP_NOSILK
C17, C79, C81, C82, C83, C84, C85, C87, C88, C89: 4.7 uF; EIA_0603_CAP_NOSILK
C18: 47 uF; EIA_1206_CAP_NOSILK
C78: 100 uF; EIA_1206_CAP_NOSILK
C80, C86, C90, C91, C92, C93, C94, C95, C96, C97, C98, C99, C100, C101, C102: 0.47 uF; EIA_0402_CAP_NOSILK
D9: GREEN; EIA_0603_LED
J10: XILINX_JTAG; XILINX_JTAG_PTH_MOLEX_0878311420
R10, R72: 33; EIA_0402_RES_NOSILK
R71, R121: 4.7K; EIA_0402_RES_NOSILK
R73: 470; EIA_0402_RES_NOSILK
SW6: SWITCH; SWITCH_RAFI_MICON_5
TP11: TESTPOINT; TESTPOINT_SMT_0.5MM
U4: XC7S15-1FTGB196C; BGA_196_15x15_FULLARRAY_1MM_FTGB196

Connections:
/1V0: C16.1, C17.1, C79.1, C80.1, C85.1, C90.1, C95.1, U4.D6 (VCCINT), U4.D8 (VCCINT), U4.E5 (VCCBRAM), U4.E7 (VCCINT), U4.E9 (VCCINT), U4.F6 (VCCINT), U4.G5 (VCCBRAM), U4.G9 (VCCINT), U4.H6 (VCCINT), U4.J5 (VCCBRAM), U4.J9 (VCCINT), U4.K6 (VCCINT), U4.K8 (VCCINT); also elsewhere on the board
/1V8: C18.1, C81.1, C86.1, C91.1, U4.B8 (VCCBATT_0), U4.F8 (VCCADC_0), U4.F10 (VCCAUX), U4.H10 (VCCAUX), U4.K10 (VCCAUX), U4.L9 (VCCAUX); also elsewhere on the board
/3V3: C78.1, C82.1, C83.1, C84.1, C87.1, C88.1, C89.1, C92.1, C93.1, C94.1, C96.1, C97.1, C98.1, C99.1, C100.1, C101.1, C102.1, J10.2 (Vccaux), R71.2, R121.2, U4.G2 (VCCO_34), U4.G13 (VCCO_14), U4.K2 (VCCO_34), U4.K13 (VCCO_14), U4.M7 (M0_0), U4.N2 (VCCO_34), U4.N6 (VCCO_0), U4.N7 (CFGBVS_0), U4.N8 (VCCO_0), U4.N13 (VCCO_14); also elsewhere on the board
/Boot Flash/FLASH_SCK: R72.2; also elsewhere on the board
/FPGA Support/FPGA_DONE: R73.1, U4.P9 (DONE_0)
/FPGA Support/FPGA_INIT_B: R71.1, TP11.1, U4.P8 (INIT_B_0)
/FPGA Support/FPGA_JTAG_TCK: J10.6 (TCK), U4.A7 (TCK_0)
/FPGA Support/FPGA_JTAG_TDI: J10.10 (TDI_OUT), U4.P7 (TDI_0)
/FPGA Support/FPGA_JTAG_TDO: J10.8 (TDO_IN), R10.1
/FPGA Support/FPGA_JTAG_TMS: J10.4 (TMS), U4.M6 (TMS_0)
/FPGA Support/FPGA_RST_N: R121.1, SW6.1, U4.L7 (PROGRAM_B_0)
/GND: C16.2, C17.2, C18.2, C78.2, C79.2, C80.2, C81.2, C82.2, C83.2, C84.2, C85.2, C86.2, C87.2, C88.2, C89.2, C90.2, C91.2, C92.2, C93.2, C94.2, C95.2, C96.2, C97.2, C98.2, C99.2, C100.2, C101.2, C102.2, D9.1 (K), J10.3 (Vss), J10.5 (Vss), J10.7 (Vss), J10.9 (Vss), J10.11 (Vss), SW6.2, U4.A1 (GND), U4.A6 (GND), U4.A9 (GND), U4.A11 (GND), U4.A14 (GND), U4.B4 (GND), U4.B7 (GND), U4.B9 (GND), U4.C2 (GND), U4.C6 (GND), U4.C7 (GND), U4.C8 (GND), U4.C9 (GND), U4.C13 (GND), U4.D5 (GND), U4.D7 (GND), U4.D9 (GND), U4.D11 (GND), U4.E1 (GND), U4.E3 (GND), U4.E6 (GND), U4.E8 (GND), U4.E10 (GND), U4.E14 (GND), U4.F5 (GND), U4.F7 (GNDADC_0), U4.F9 (GND), U4.G3 (GND), U4.G6 (GND), U4.G7 (VREFN_0), U4.G8 (VP_0), U4.G10 (GND), U4.G12 (GND), U4.H5 (GND), U4.H7 (VN_0), U4.H8 (VREFP_0), U4.H9 (GND), U4.J6 (GND), U4.J7 (DXN_0), U4.J8 (DXP_0), U4.J10 (GND), U4.K1 (GND), U4.K5 (GND), U4.K7 (GND), U4.K9 (GND), U4.K14 (GND), U4.L4 (GND), U4.L6 (GND), U4.L8 (GND), U4.L10 (GND), U4.L11 (GND), U4.M8 (M1_0), U4.M9 (M2_0), U4.N3 (GND), U4.N5 (GND), U4.N9 (GND), U4.N12 (GND), U4.P1 (GND), U4.P14 (GND); also elsewhere on the board
unnamed: D9.2 (A), R73.2
unnamed: R10.2, U4.P6 (TDO_0)
unnamed: R72.1, U4.A8 (CCLK_0)

Notes on the sheet:
VCCINT
VCCO bank 0
VCCO bank 34
VCCO bank 14
FPGA decoupling assumes XC7S15 If loading XC7S6, can DNP C15 and C26 XC7S25/50 need more caps and are not compatible with this layout.
VCCAUX
VCCBRAM
