azonenberg/ethernet-tap/board/ethernet-tap.kicad_pcb

## KiCad design board/ethernet-tap.kicad_pcb (continued)

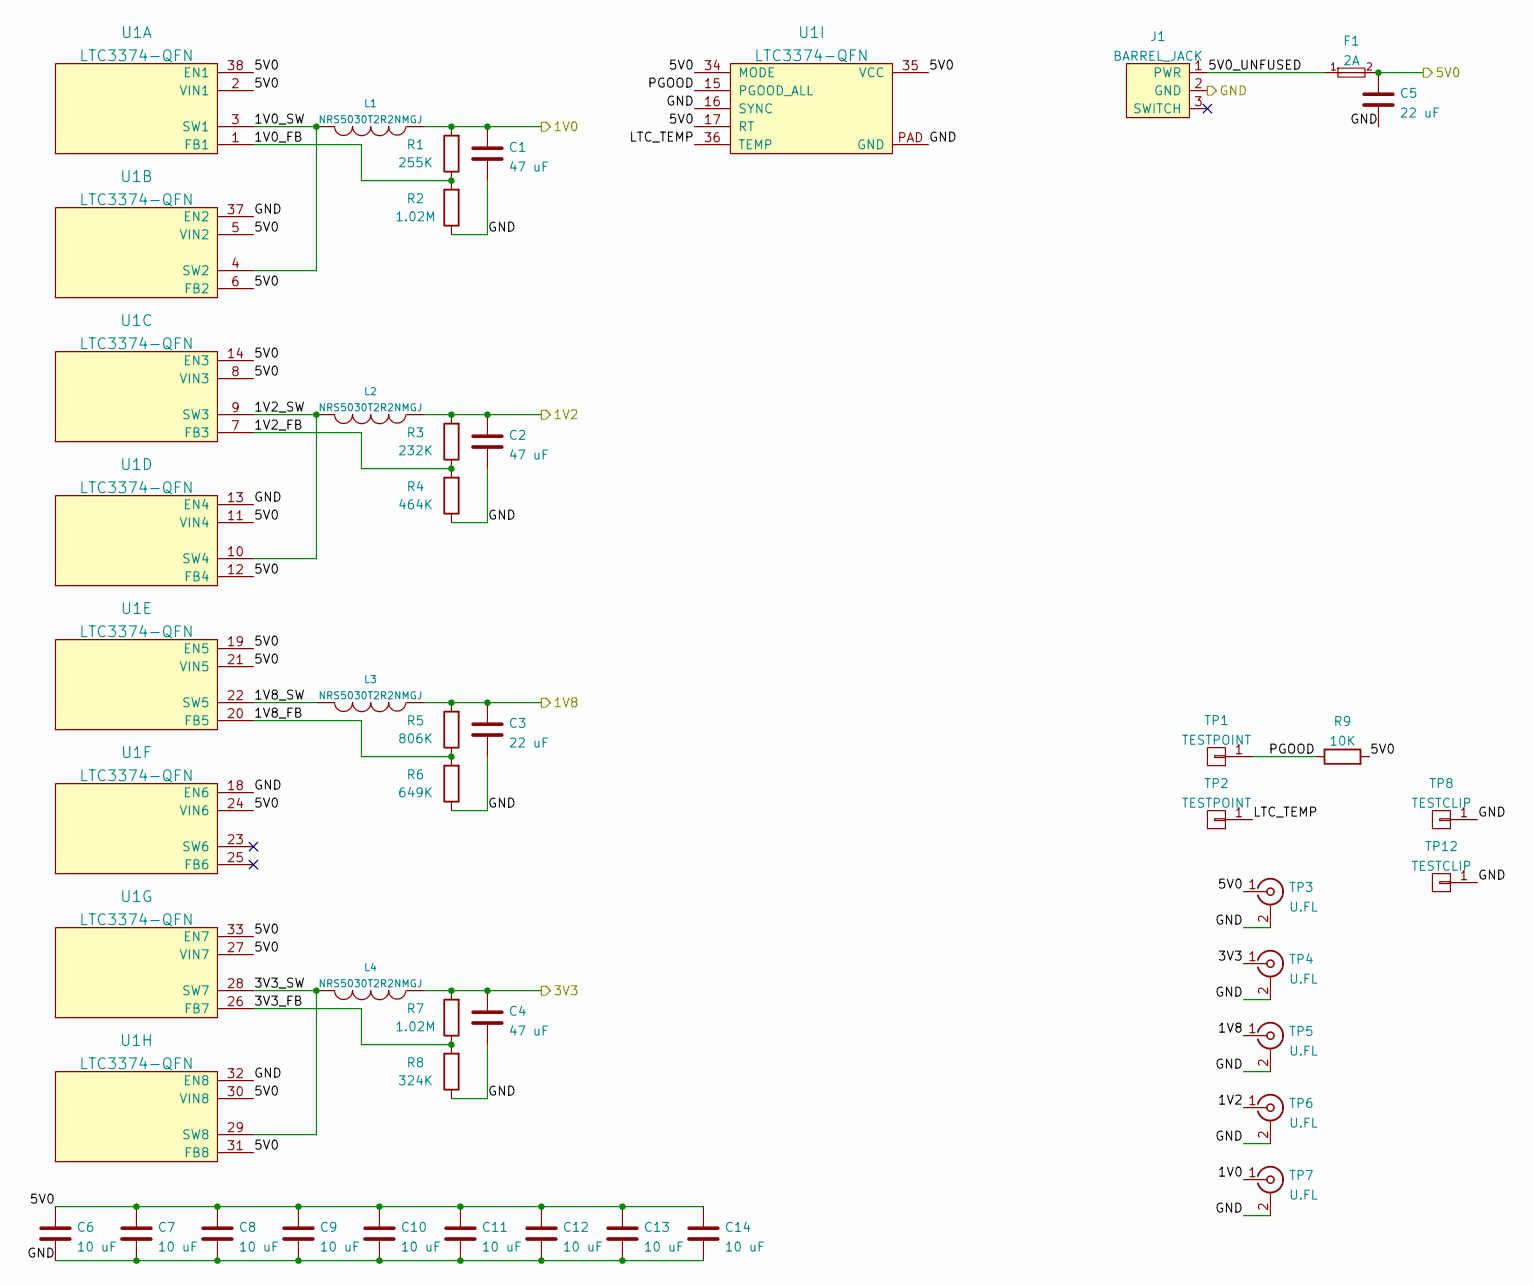
[picture p6: schematic psu.kicad_sch, Active 10/100/1000baseT Tap]

Parts:
C1, C2, C4: 47 uF; EIA_1210_CAP_NOSILK
C3, C5: 22 uF; EIA_1206_CAP_NOSILK
C6, C7, C8, C9, C10, C11, C12, C13, C14: 10 uF; EIA_1210_CAP_NOSILK
F1: 2A; EIA_0603_CAP_NOSILK
J1: BARREL_JACK; CONN_CUI_PJ-058BH_HIPWR_BARREL_NOSLOT
L1, L2, L3, L4: NRS5030T2R2NMGJ; INDUCTOR_YUDEN_NRS5030
R1: 255K; EIA_0402_RES_NOSILK
R2, R7: 1.02M; EIA_0402_RES_NOSILK
R3: 232K; EIA_0402_RES_NOSILK
R4: 464K; EIA_0402_RES_NOSILK
R5: 806K; EIA_0402_RES_NOSILK
R6: 649K; EIA_0402_RES_NOSILK
R8: 324K; EIA_0402_RES_NOSILK
R9: 10K; EIA_0402_RES_NOSILK
TP1, TP2: TESTPOINT; TESTPOINT_SMT_0.5MM
TP3, TP4, TP5, TP6, TP7: U.FL; CONN_U.FL_TE_1909763-1
TP8, TP12: TESTCLIP; TESTPOINT_SMT_KEYSTONE_5016
U1: LTC3374-QFN; QFN_38_0.5MM_5x7MM

Connections:
/1V0: C1.1, L1.1, R1.2, TP7.1 (In); also elsewhere on the board
/1V2: C2.1, L2.1, R3.2, TP6.1 (In); also elsewhere on the board
/1V8: C3.1, L3.1, R5.2, TP5.1 (In); also elsewhere on the board
/3V3: C4.1, L4.1, R7.2, TP4.1 (In); also elsewhere on the board
/5V0: C5.1, C6.1, C7.1, C8.1, C9.1, C10.1, C11.1, C12.1, C13.1, C14.1, F1.2, R9.2, TP3.1 (In), U1.2 (VIN1), U1.5 (VIN2), U1.6 (FB2), U1.8 (VIN3), U1.11 (VIN4), U1.12 (FB4), U1.14 (EN3), U1.17 (RT), U1.19 (EN5), U1.21 (VIN5), U1.24 (VIN6), U1.27 (VIN7), U1.30 (VIN8), U1.31 (FB8), U1.33 (EN7), U1.34 (MODE), U1.35 (VCC), U1.38 (EN1); also elsewhere on the board
/GND: C1.2, C2.2, C3.2, C4.2, C5.2, C6.2, C7.2, C8.2, C9.2, C10.2, C11.2, C12.2, C13.2, C14.2, J1.2 (GND), R2.1, R4.1, R6.1, R8.1, TP3.2 (Ext), TP4.2 (Ext), TP5.2 (Ext), TP6.2 (Ext), TP7.2 (Ext), TP8.1, TP12.1, U1.13 (EN4), U1.16 (SYNC), U1.18 (EN6), U1.32 (EN8), U1.37 (EN2), U1.PAD (GND); also elsewhere on the board
/Power Supply/1V0_FB: R1.1, R2.2, U1.1 (FB1)
/Power Supply/1V0_SW: L1.2, U1.3 (SW1), U1.4 (SW2)
/Power Supply/1V2_FB: R3.1, R4.2, U1.7 (FB3)
/Power Supply/1V2_SW: L2.2, U1.9 (SW3), U1.10 (SW4)
/Power Supply/1V8_FB: R5.1, R6.2, U1.20 (FB5)
/Power Supply/1V8_SW: L3.2, U1.22 (SW5)
/Power Supply/3V3_FB: R7.1, R8.2, U1.26 (FB7)
/Power Supply/3V3_SW: L4.2, U1.28 (SW7), U1.29 (SW8)
/Power Supply/5V0_UNFUSED: F1.1, J1.1 (PWR)
/Power Supply/LTC_TEMP: TP2.1, U1.36 (TEMP)
/Power Supply/PGOOD: R9.1, TP1.1, U1.15 (PGOOD_ALL)

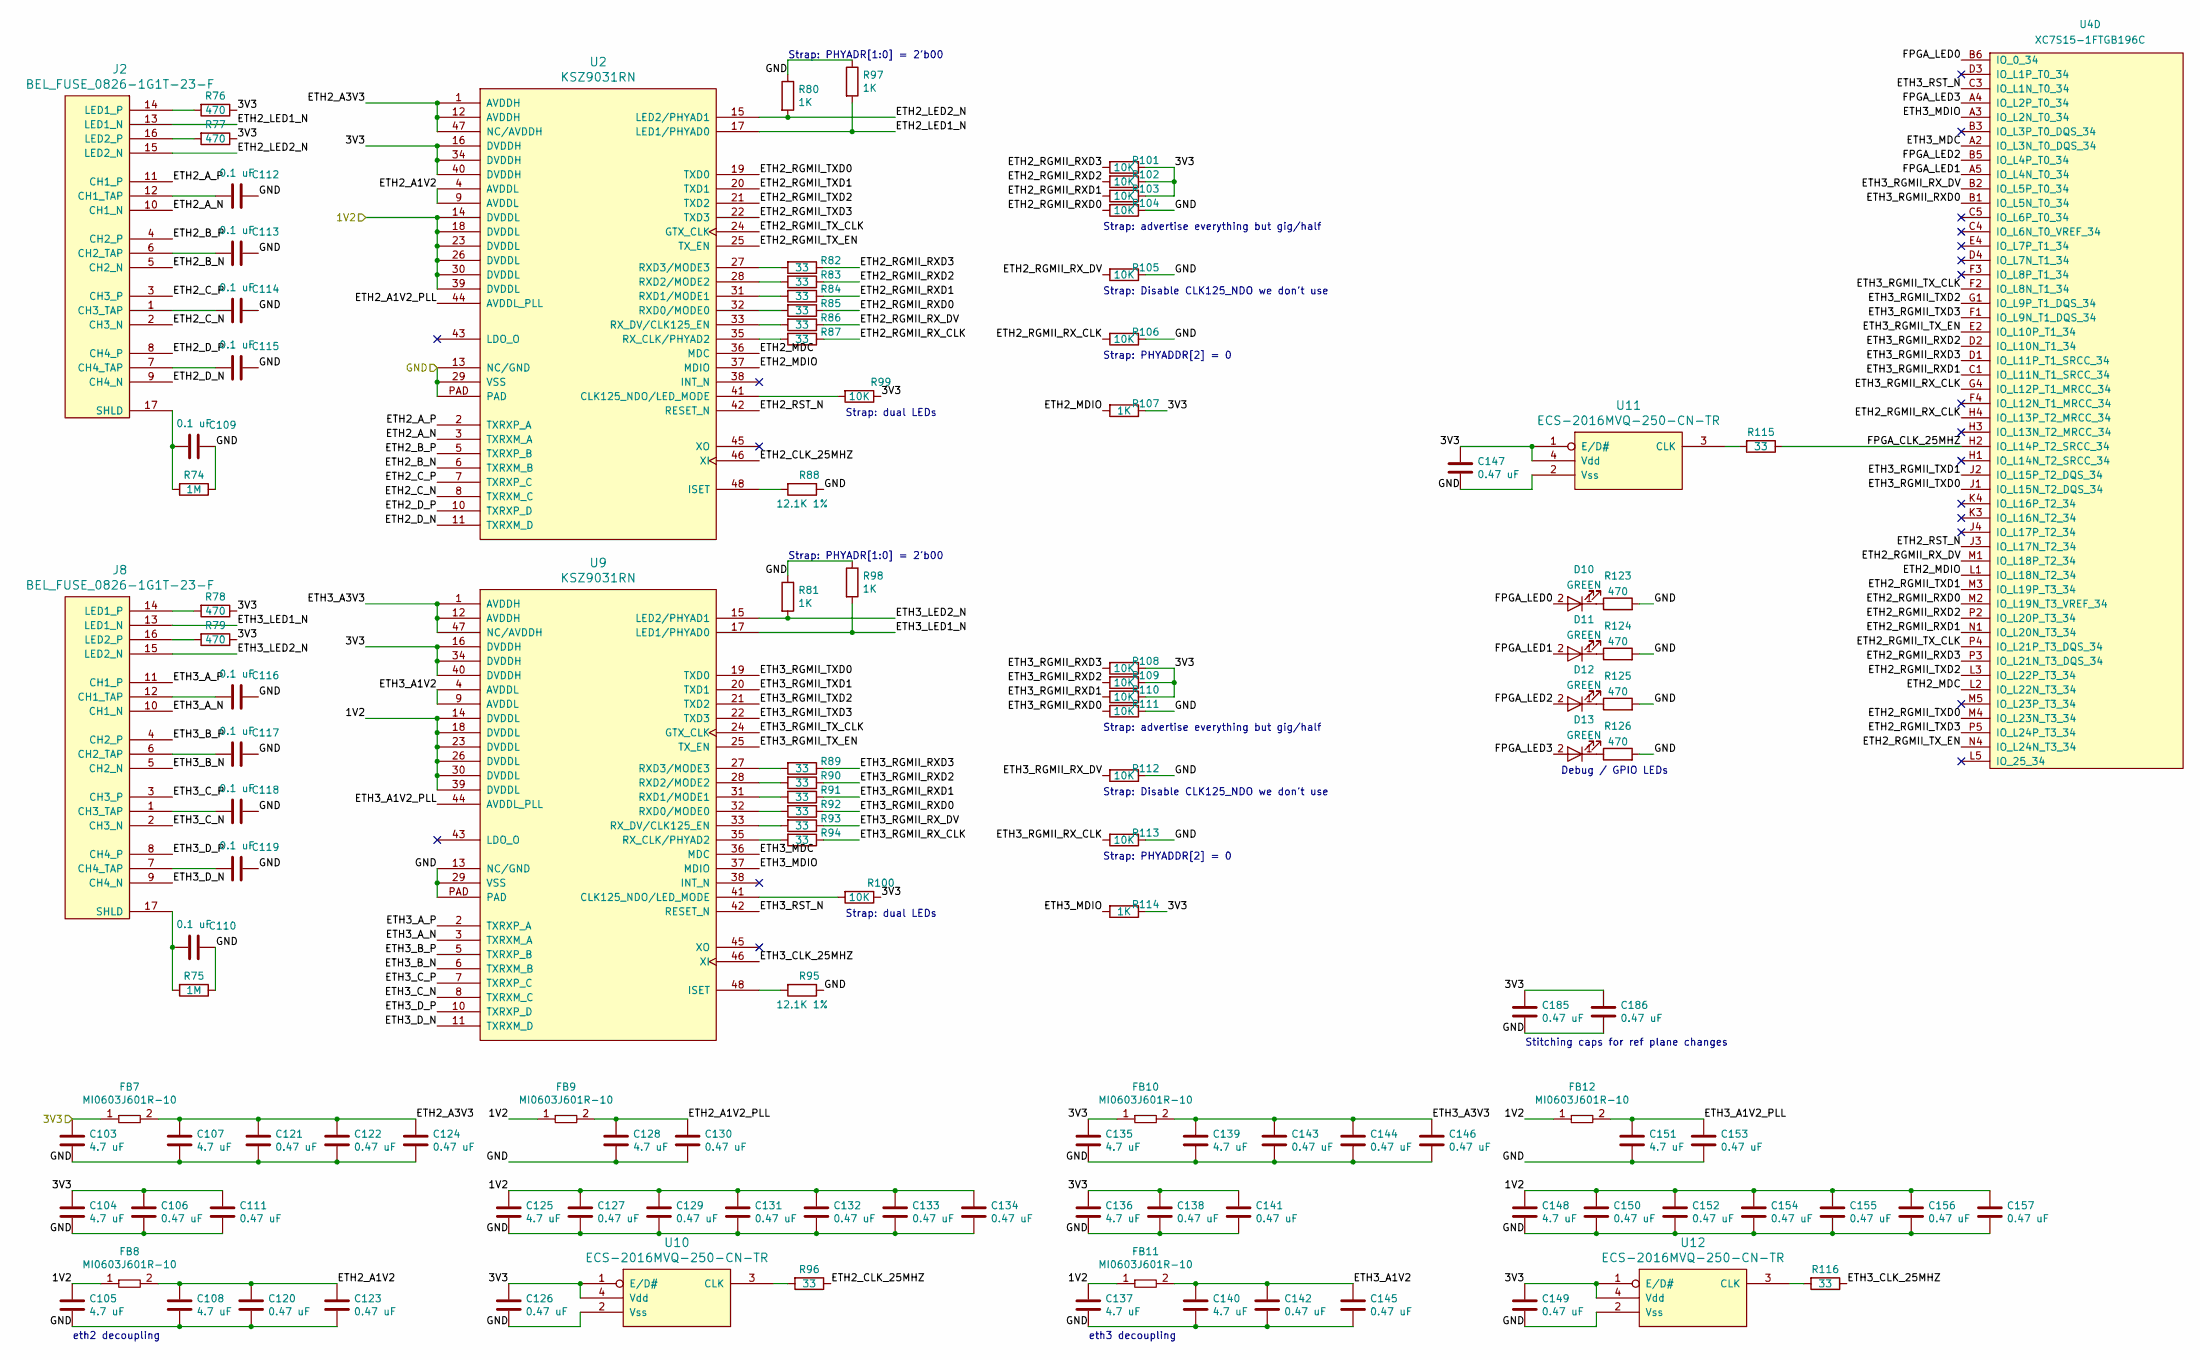
[picture p7: schematic monpath.kicad_sch, Active 10/100/1000baseT Tap]

Parts:
C103, C104, C105, C107, C108, C125, C128, C135, C136, C137, C139, C140, C148, C151: 4.7 uF; EIA_0603_CAP_NOSILK
C106, C111, C120, C121, C122, C123, C124, C126, C127, C129, C130, C131, C132, C133, C134, C138, C141, C142, C143, C144, C145, C146, C147, C149, C150, C152, C153, C154, C155, C156, C157, C185, C186: 0.47 uF; EIA_0402_CAP_NOSILK
C109, C110, C112, C113, C114, C115, C116, C117, C118, C119: 0.1 uF; EIA_0402_CAP_NOSILK
D10, D11, D12, D13: GREEN; EIA_0603_LED
FB7, FB8, FB9, FB10, FB11, FB12: MI0603J601R-10; EIA_0603_INDUCTOR_NOSILK
J2, J8: BEL_FUSE_0826-1G1T-23-F; CONN_BELFUSE_0826_1G1T_23_F
R74, R75: 1M; EIA_0402_RES_NOSILK
R76, R77, R78, R79, R123, R124, R125, R126: 470; EIA_0402_RES_NOSILK
R80, R81, R97, R98, R107, R114: 1K; EIA_0402_RES_NOSILK
R82, R83, R84, R85, R86, R87, R89, R90, R91, R92, R93, R94, R96, R115, R116: 33; EIA_0402_RES_NOSILK
R88, R95: 12.1K 1%; EIA_0402_RES_NOSILK
R99, R100, R101, R102, R103, R104, R105, R106, R108, R109, R110, R111, R112, R113: 10K; EIA_0402_RES_NOSILK
U2, U9: KSZ9031RN; QFN_48_0.5MM_7x7MM
U4: XC7S15-1FTGB196C; BGA_196_15x15_FULLARRAY_1MM_FTGB196
U10, U11, U12: ECS-2016MVQ-250-CN-TR; OSCILLATOR_2.0x1.6

Connections:
/1V2: C105.1, C125.1, C127.1, C129.1, C131.1, C132.1, C133.1, C134.1, C137.1, C148.1, C150.1, C152.1, C154.1, C155.1, C156.1, C157.1, FB8.1, FB9.1, FB11.1, FB12.1, U2.14 (DVDDL), U2.18 (DVDDL), U2.23 (DVDDL), U2.26 (DVDDL), U2.30 (DVDDL), U2.39 (DVDDL), U9.14 (DVDDL), U9.18 (DVDDL), U9.23 (DVDDL), U9.26 (DVDDL), U9.30 (DVDDL), U9.39 (DVDDL); also elsewhere on the board
/3V3: C103.1, C104.1, C106.1, C111.1, C126.1, C135.1, C136.1, C138.1, C141.1, C147.1, C149.1, C185.1, C186.1, FB7.1, FB10.1, R76.1, R77.1, R78.1, R79.1, R99.1, R100.1, R101.1, R102.1, R103.1, R107.1, R108.1, R109.1, R110.1, R114.1, U2.16 (DVDDH), U2.34 (DVDDH), U2.40 (DVDDH), U9.16 (DVDDH), U9.34 (DVDDH), U9.40 (DVDDH), U10.1 (E/D#), U10.4 (Vdd), U11.1 (E/D#), U11.4 (Vdd), U12.1 (E/D#), U12.4 (Vdd); also elsewhere on the board
/GND: C103.2, C104.2, C105.2, C106.2, C107.2, C108.2, C109.1, C110.1, C111.2, C112.1, C113.1, C114.1, C115.1, C116.1, C117.1, C118.1, C119.1, C120.2, C121.2, C122.2, C123.2, C124.2, C125.2, C126.2, C127.2, C128.2, C129.2, C130.2, C131.2, C132.2, C133.2, C134.2, C135.2, C136.2, C137.2, C138.2, C139.2, C140.2, C141.2, C142.2, C143.2, C144.2, C145.2, C146.2, C147.2, C148.2, C149.2, C150.2, C151.2, C152.2, C153.2, C154.2, C155.2, C156.2, C157.2, C185.2, C186.2, R74.1, R75.1, R80.1, R81.1, R88.1, R95.1, R97.1, R98.1, R104.1, R105.1, R106.1, R111.1, R112.1, R113.1, R123.2, R124.2, R125.2, R126.2, U2.13 (NC/GND), U2.29 (VSS), U2.PAD, U9.13 (NC/GND), U9.29 (VSS), U9.PAD, U10.2 (Vss), U11.2 (Vss), U12.2 (Vss); also elsewhere on the board
/Monitor Path/ETH2_A1V2: C108.1, C120.1, C123.1, FB8.2, U2.4 (AVDDL), U2.9 (AVDDL)
/Monitor Path/ETH2_A1V2_PLL: C128.1, C130.1, FB9.2, U2.44 (AVDDL_PLL)
/Monitor Path/ETH2_A3V3: C107.1, C121.1, C122.1, C124.1, FB7.2, U2.1 (AVDDH), U2.12 (AVDDH), U2.47 (NC/AVDDH)
/Monitor Path/ETH2_A_N: J2.10 (CH1_N), U2.3 (TXRXM_A)
/Monitor Path/ETH2_A_P: J2.11 (CH1_P), U2.2 (TXRXP_A)
/Monitor Path/ETH2_B_N: J2.5 (CH2_N), U2.6 (TXRXM_B)
/Monitor Path/ETH2_B_P: J2.4 (CH2_P), U2.5 (TXRXP_B)
/Monitor Path/ETH2_CLK_25MHZ: R96.1, U2.46 (XI)
/Monitor Path/ETH2_C_N: J2.2 (CH3_N), U2.8 (TXRXM_C)
/Monitor Path/ETH2_C_P: J2.3 (CH3_P), U2.7 (TXRXP_C)
/Monitor Path/ETH2_D_N: J2.9 (CH4_N), U2.11 (TXRXM_D)
/Monitor Path/ETH2_D_P: J2.8 (CH4_P), U2.10 (TXRXP_D)
/Monitor Path/ETH2_LED1_N: J2.13 (LED1_N), R97.2, U2.17 (LED1/PHYAD0)
/Monitor Path/ETH2_LED2_N: J2.15 (LED2_N), R80.2, U2.15 (LED2/PHYAD1)
/Monitor Path/ETH2_MDC: U2.36 (MDC), U4.L2 (IO_L22N_T3_34)
/Monitor Path/ETH2_MDIO: R107.2, U2.37 (MDIO), U4.L1 (IO_L18N_T2_34)
/Monitor Path/ETH2_RGMII_RXD0: R85.1, R104.2, U4.M2 (IO_L19N_T3_VREF_34)
/Monitor Path/ETH2_RGMII_RXD1: R84.1, R103.2, U4.N1 (IO_L20N_T3_34)
/Monitor Path/ETH2_RGMII_RXD2: R83.1, R102.2, U4.P2 (IO_L20P_T3_34)
/Monitor Path/ETH2_RGMII_RXD3: R82.1, R101.2, U4.P3 (IO_L21N_T3_DQS_34)
/Monitor Path/ETH2_RGMII_RX_CLK: R87.1, R106.2, U4.H4 (IO_L13P_T2_MRCC_34)
/Monitor Path/ETH2_RGMII_RX_DV: R86.1, R105.2, U4.M1 (IO_L18P_T2_34)
/Monitor Path/ETH2_RGMII_TXD0: U2.19 (TXD0), U4.M4 (IO_L23N_T3_34)
/Monitor Path/ETH2_RGMII_TXD1: U2.20 (TXD1), U4.M3 (IO_L19P_T3_34)
/Monitor Path/ETH2_RGMII_TXD2: U2.21 (TXD2), U4.L3 (IO_L22P_T3_34)
/Monitor Path/ETH2_RGMII_TXD3: U2.22 (TXD3), U4.P5 (IO_L24P_T3_34)
/Monitor Path/ETH2_RGMII_TX_CLK: U2.24 (GTX_CLK), U4.P4 (IO_L21P_T3_DQS_34)
/Monitor Path/ETH2_RGMII_TX_EN: U2.25 (TX_EN), U4.N4 (IO_L24N_T3_34)
/Monitor Path/ETH2_RST_N: U2.42 (RESET_N), U4.J3 (IO_L17N_T2_34)
/Monitor Path/ETH3_A1V2: C140.1, C142.1, C145.1, FB11.2, U9.4 (AVDDL), U9.9 (AVDDL)
/Monitor Path/ETH3_A1V2_PLL: C151.1, C153.1, FB12.2, U9.44 (AVDDL_PLL)
/Monitor Path/ETH3_A3V3: C139.1, C143.1, C144.1, C146.1, FB10.2, U9.1 (AVDDH), U9.12 (AVDDH), U9.47 (NC/AVDDH)
/Monitor Path/ETH3_A_N: J8.10 (CH1_N), U9.3 (TXRXM_A)
/Monitor Path/ETH3_A_P: J8.11 (CH1_P), U9.2 (TXRXP_A)
/Monitor Path/ETH3_B_N: J8.5 (CH2_N), U9.6 (TXRXM_B)
/Monitor Path/ETH3_B_P: J8.4 (CH2_P), U9.5 (TXRXP_B)
/Monitor Path/ETH3_CLK_25MHZ: R116.1, U9.46 (XI)
/Monitor Path/ETH3_C_N: J8.2 (CH3_N), U9.8 (TXRXM_C)
/Monitor Path/ETH3_C_P: J8.3 (CH3_P), U9.7 (TXRXP_C)
/Monitor Path/ETH3_D_N: J8.9 (CH4_N), U9.11 (TXRXM_D)
/Monitor Path/ETH3_D_P: J8.8 (CH4_P), U9.10 (TXRXP_D)
/Monitor Path/ETH3_LED1_N: J8.13 (LED1_N), R98.2, U9.17 (LED1/PHYAD0)
/Monitor Path/ETH3_LED2_N: J8.15 (LED2_N), R81.2, U9.15 (LED2/PHYAD1)
/Monitor Path/ETH3_MDC: U4.A2 (IO_L3N_T0_DQS_34), U9.36 (MDC)
/Monitor Path/ETH3_MDIO: R114.2, U4.A3 (IO_L2N_T0_34), U9.37 (MDIO)
/Monitor Path/ETH3_RGMII_RXD0: R92.1, R111.2, U4.B1 (IO_L5N_T0_34)
/Monitor Path/ETH3_RGMII_RXD1: R91.1, R110.2, U4.C1 (IO_L11N_T1_SRCC_34)
/Monitor Path/ETH3_RGMII_RXD2: R90.1, R109.2, U4.D2 (IO_L10N_T1_34)
/Monitor Path/ETH3_RGMII_RXD3: R89.1, R108.2, U4.D1 (IO_L11P_T1_SRCC_34)
/Monitor Path/ETH3_RGMII_RX_CLK: R94.1, R113.2, U4.G4 (IO_L12P_T1_MRCC_34)
/Monitor Path/ETH3_RGMII_RX_DV: R93.1, R112.2, U4.B2 (IO_L5P_T0_34)
/Monitor Path/ETH3_RGMII_TXD0: U4.J1 (IO_L15N_T2_DQS_34), U9.19 (TXD0)
/Monitor Path/ETH3_RGMII_TXD1: U4.J2 (IO_L15P_T2_DQS_34), U9.20 (TXD1)
/Monitor Path/ETH3_RGMII_TXD2: U4.G1 (IO_L9P_T1_DQS_34), U9.21 (TXD2)
/Monitor Path/ETH3_RGMII_TXD3: U4.F1 (IO_L9N_T1_DQS_34), U9.22 (TXD3)
/Monitor Path/ETH3_RGMII_TX_CLK: U4.F2 (IO_L8N_T1_34), U9.24 (GTX_CLK)
/Monitor Path/ETH3_RGMII_TX_EN: U4.E2 (IO_L10P_T1_34), U9.25 (TX_EN)
/Monitor Path/ETH3_RST_N: U4.C3 (IO_L1N_T0_34), U9.42 (RESET_N)
/Monitor Path/FPGA_CLK_25MHZ: R115.1, U4.H2 (IO_L14P_T2_SRCC_34)
/Monitor Path/FPGA_LED0: D10.2 (A), U4.B6 (IO_0_34)
/Monitor Path/FPGA_LED1: D11.2 (A), U4.A5 (IO_L4N_T0_34)
/Monitor Path/FPGA_LED2: D12.2 (A), U4.B5 (IO_L4P_T0_34)
/Monitor Path/FPGA_LED3: D13.2 (A), U4.A4 (IO_L2P_T0_34)
unnamed: C109.2, J2.17 (SHLD), R74.2
unnamed: C110.2, J8.17 (SHLD), R75.2
unnamed: C112.2, J2.12 (CH1_TAP)
unnamed: C113.2, J2.6 (CH2_TAP)
unnamed: C114.2, J2.1 (CH3_TAP)
unnamed: C115.2, J2.7 (CH4_TAP)
unnamed: C116.2, J8.12 (CH1_TAP)
unnamed: C117.2, J8.6 (CH2_TAP)
unnamed: C118.2, J8.1 (CH3_TAP)
unnamed: C119.2, J8.7 (CH4_TAP)
unnamed: D10.1 (K), R123.1
unnamed: D11.1 (K), R124.1
unnamed: D12.1 (K), R125.1
unnamed: D13.1 (K), R126.1
unnamed: J2.14 (LED1_P), R76.2
unnamed: J2.16 (LED2_P), R77.2
unnamed: J8.14 (LED1_P), R78.2
unnamed: J8.16 (LED2_P), R79.2
unnamed: R82.2, U2.27 (RXD3/MODE3)
unnamed: R83.2, U2.28 (RXD2/MODE2)
unnamed: R84.2, U2.31 (RXD1/MODE1)
unnamed: R85.2, U2.32 (RXD0/MODE0)
unnamed: R86.2, U2.33 (RX_DV/CLK125_EN)
unnamed: R87.2, U2.35 (RX_CLK/PHYAD2)
unnamed: R88.2, U2.48 (ISET)
unnamed: R89.2, U9.27 (RXD3/MODE3)
unnamed: R90.2, U9.28 (RXD2/MODE2)
unnamed: R91.2, U9.31 (RXD1/MODE1)
unnamed: R92.2, U9.32 (RXD0/MODE0)
unnamed: R93.2, U9.33 (RX_DV/CLK125_EN)
unnamed: R94.2, U9.35 (RX_CLK/PHYAD2)
unnamed: R95.2, U9.48 (ISET)
unnamed: R96.2, U10.3 (CLK)
unnamed: R99.2, U2.41 (CLK125_NDO/LED_MODE)
unnamed: R100.2, U9.41 (CLK125_NDO/LED_MODE)
unnamed: R115.2, U11.3 (CLK)
unnamed: R116.2, U12.3 (CLK)

Notes on the sheet:
Strap: dual LEDs
Strap: PHYADR[1:0] = 2'b00
eth2 decoupling
Strap: PHYADDR[2] = 0
Strap: Disable CLK125_NDO we don't use
Strap: advertise everything but gig/half
eth3 decoupling
Stitching caps for ref plane changes
Debug / GPIO LEDs

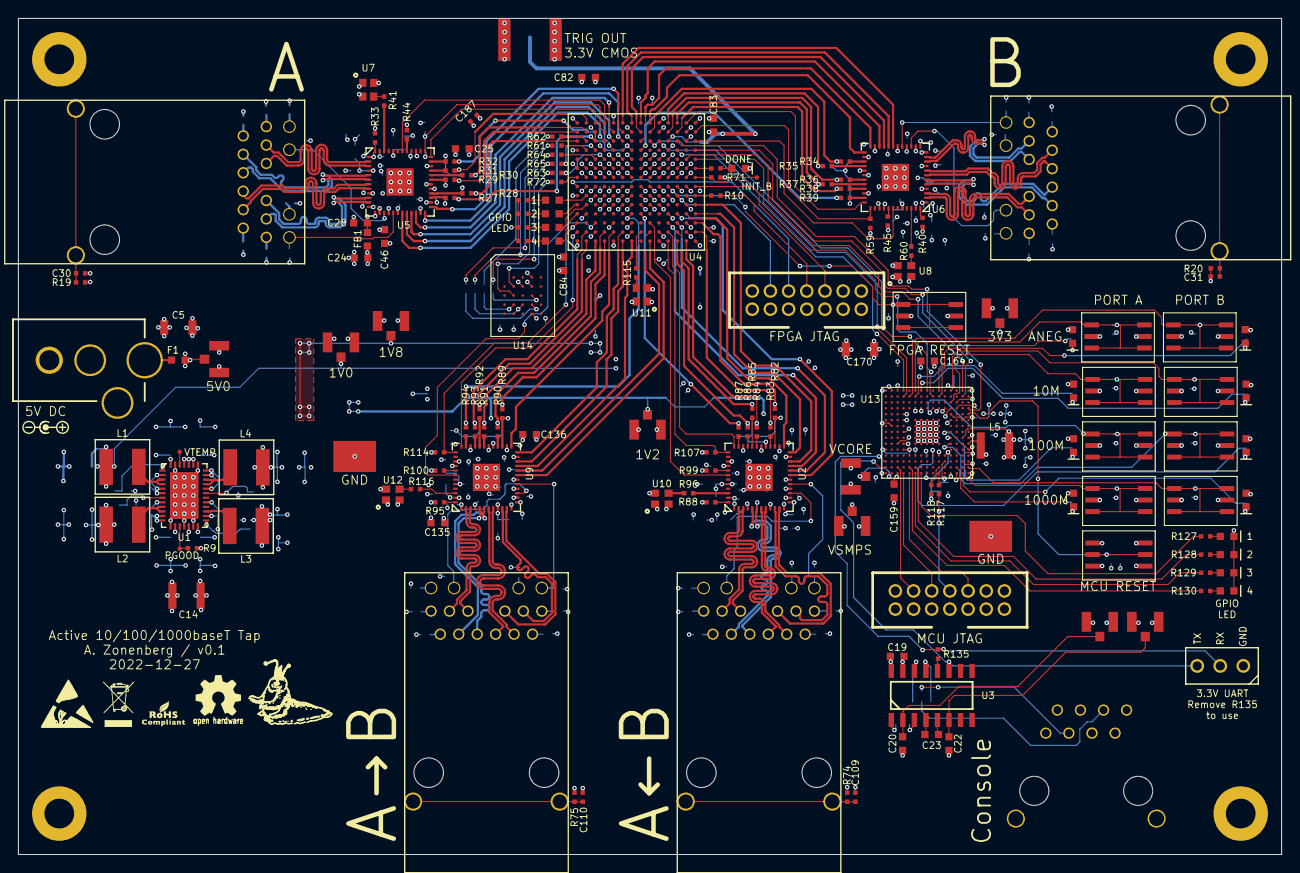
[picture p8: board ethernet-tap.kicad_pcb from above]

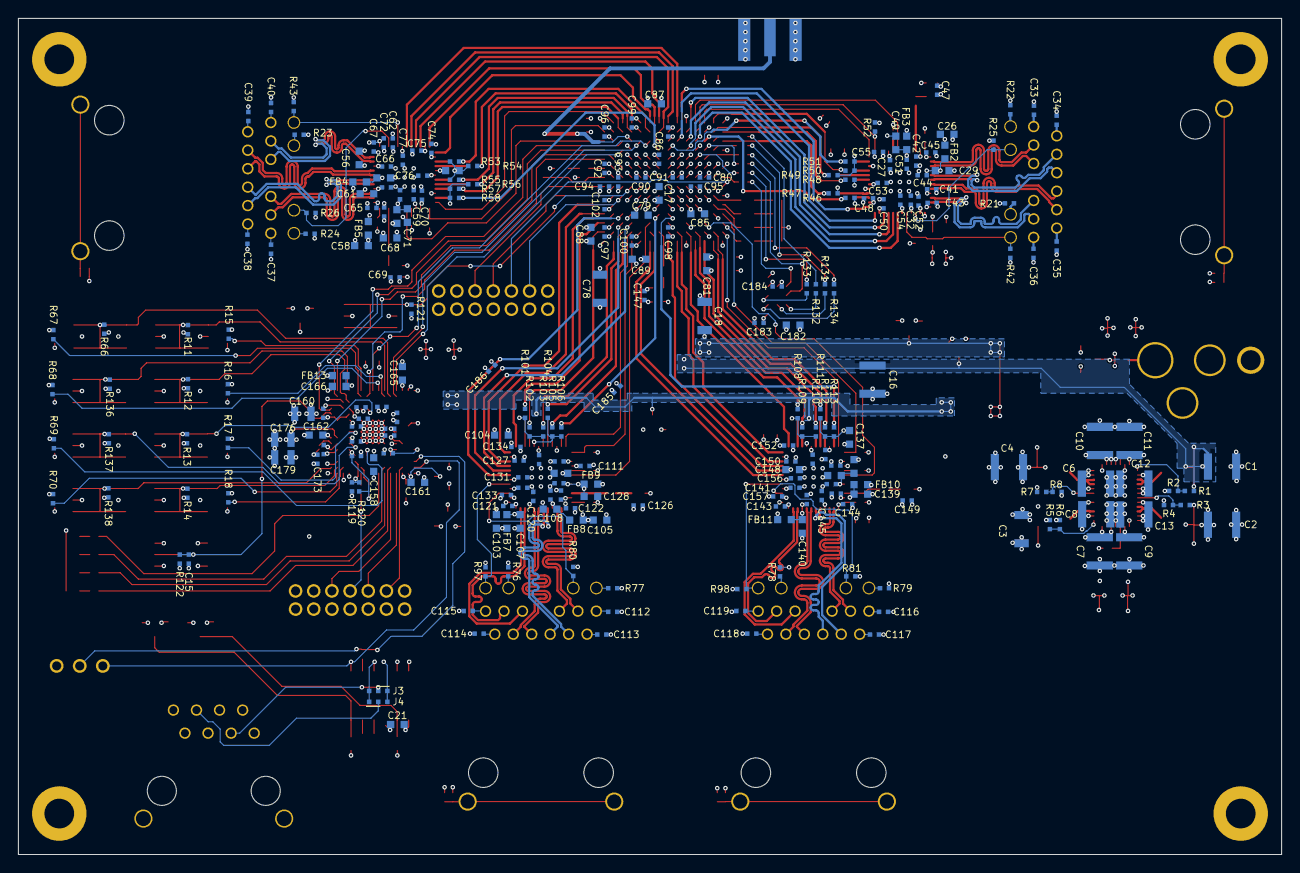
[picture p9: board ethernet-tap.kicad_pcb from below]

Board: 4 copper layers, 139.0 x 92.0 mm, 415 parts (252 on the bottom side), 297 nets.
