azonenberg/ethernet-tap/(commit log)

2022-12-20 Initial power budget docs
    [power-budget.ods]
2022-12-20 Initial schematic
    [ethernet-tap.kicad_pcb, ethernet-tap.kicad_sch, fpgasupport.kicad_sch, mgmt.kicad_sch, monpath.kicad_sch, psu.kicad_sch, thrupath.kicad_sch]
2022-12-20 Continued initial schematic capture
    [bootflash.kicad_sch, ethernet-tap.kicad_sch, fpgasupport.kicad_sch, mgmt.kicad_sch, monpath.kicad_sch, psu.kicad_sch, thrupath.kicad_sch]
2022-12-21 Finished initial schematic, ready for signoff review
    [bootflash.kicad_sch, ethernet-tap.kicad_sch, fpgasupport.kicad_sch, mgmt.kicad_sch, monpath.kicad_sch, psu.kicad_sch, thrupath.kicad_sch]
2022-12-21 Finished schematic review. Added a few more test points.
    [ethernet-tap.kicad_sch, fpgasupport.kicad_sch, mgmt.kicad_sch, psu.kicad_sch]
2022-12-21 Continued initial layout. First PHY fully routed including connection to FPGA. Hooked up 0402 bypass caps under FPGA. Flash is roughly placed.
    [bootflash.kicad_sch, ethernet-tap.kicad_pcb, ethernet-tap.kicad_sch, fpgasupport.kicad_sch, mgmt.kicad_sch, monpath.kicad_sch, psu.kicad_sch, thrupath.kicad_sch]
2022-12-21 Good progress hooking up second PHY
    [ethernet-tap.kicad_pcb]
2022-12-22 Continued initial layout. Good progress on monitor port PHYs.
    [ethernet-tap.kicad_pcb]
2022-12-23 Continued work on monitor port PHY layout
    [ethernet-tap.kicad_pcb]
2022-12-23 Shrunk board down to 139 x 92 mm
    [ethernet-tap.kicad_pcb]
2022-12-23 Finished power supply layout, added mounting holes and a bunch of silkscreen labeling
    [bootflash.kicad_sch, ethernet-tap.kicad_pcb, ethernet-tap.kicad_sch, fpgasupport.kicad_sch, mgmt.kicad_sch, monpath.kicad_sch, psu.kicad_sch, thrupath.kicad_sch]
2022-12-24 Continued work on layout. Monitor port PHys are now done, as is FPGA JTAG and reset
    [ethernet-tap.kicad_pcb, monpath.kicad_sch]
2022-12-24 Good progress on initial layout of MCU subsystem
    [bootflash.kicad_sch, ethernet-tap.kicad_pcb, ethernet-tap.kicad_sch, fpgasupport.kicad_sch, mgmt.kicad_sch, monpath.kicad_sch, psu.kicad_sch, thrupath.kicad_sch]
2022-12-26 Updating file: ethernet-tap.kicad_pcb with current fully routed design.
    [bootflash.kicad_sch, ethernet-tap.kicad_pcb, ethernet-tap.kicad_sch, fpgasupport.kicad_sch, mgmt.kicad_sch, monpath.kicad_sch, psu.kicad_sch, thrupath.kicad_sch]
2022-12-27 Finished power plane routing, moved some signals around to reduce layer split crossings
    [ethernet-tap.kicad_pcb]
2022-12-27 DRC fixes to layout
    [ethernet-tap.kicad_pcb, psu.kicad_sch]
2022-12-27 Final v0.1 layout after design review
    [bootflash.kicad_sch, ethernet-tap.kicad_pcb, ethernet-tap.kicad_sch, fpgasupport.kicad_sch, mgmt.kicad_sch, monpath.kicad_sch, psu.kicad_sch, thrupath.kicad_sch]
2023-01-18 FPGA and MCU are now talking via quad SPI
2023-01-19 Initial firmware is now at minimum viable "no-frills tap" stage
2023-01-19 Config fixes for quad SPI mode. Fixed swapped MDIO/MDC on monA/monB interfaces. Added boot time delay to make sure FPGA is ready before we start trying to poke registers.
    [TapTop.xdc, main.cpp]
2023-01-19 Packet datapath now resets when link speed or state changes
    [PacketDatapath.sv, TapTop.sv, TapTop.xdc]
2023-01-20 Implemented TDR cable test
2023-01-21 Minor grammar fixes to "show volatility"
    [TapCLISessionContext.cpp]
2023-01-21 Added "show detail" interface command to print almost all PHY registers
